liacson-ops/3d-pato-criollo/salida/resumen.md

# Resumen del modelo v0

- Masa total estimada: **1.36 kg**
- Servos: 8× MG996R, 5× MG90S
- Piezas impresas: 31 (460 g de PLA/TPU, con el relleno indicado)

| Paso | Pieza | Tipo | Masa (g) | Descripción |
| ---: | --- | --- | ---: | --- |
| 1 | `paleta_pie_der` | impresa | 10.7 | Pie de pato (paleta) |
| 1 | `paleta_pie_izq` | impresa | 10.7 | Pie de pato (paleta) |
| 1 | `servo_tobillo_der` | comprada | 55.0 | MG996R tobillo (acostado, en el pie) |
| 1 | `servo_tobillo_izq` | comprada | 55.0 | MG996R tobillo (acostado, en el pie) |
| 1 | `soporte_pie_der` | impresa | 15.2 | Cuna del servo del tobillo, sobre la paleta |
| 1 | `soporte_pie_izq` | impresa | 15.2 | Cuna del servo del tobillo, sobre la paleta |
| 1 | `suela_der` | tpu | 4.2 | Suela de TPU |
| 1 | `suela_izq` | tpu | 4.2 | Suela de TPU |
| 2 | `horn_tobillo_der` | comprada | 2.0 |  |
| 2 | `horn_tobillo_izq` | comprada | 2.0 |  |
| 2 | `servo_rodilla_der` | comprada | 55.0 | MG996R rodilla (acostado, en la canilla) |
| 2 | `servo_rodilla_izq` | comprada | 55.0 | MG996R rodilla (acostado, en la canilla) |
| 2 | `soporte_canilla_der` | impresa | 16.7 | Canilla: cuna del servo de la rodilla; abajo recibe el horn del tobillo |
| 2 | `soporte_canilla_izq` | impresa | 16.7 | Canilla: cuna del servo de la rodilla; abajo recibe el horn del tobillo |
| 3 | `horn_rodilla_der` | comprada | 2.0 |  |
| 3 | `horn_rodilla_izq` | comprada | 2.0 |  |
| 3 | `servo_cadera_pitch_der` | comprada | 55.0 | MG996R cadera pitch (acostado, en el muslo) |
| 3 | `servo_cadera_pitch_izq` | comprada | 55.0 | MG996R cadera pitch (acostado, en el muslo) |
| 3 | `soporte_muslo_der` | impresa | 16.7 | Muslo: cuna del servo pitch de cadera; abajo recibe el horn de la rodilla |
| 3 | `soporte_muslo_izq` | impresa | 16.7 | Muslo: cuna del servo pitch de cadera; abajo recibe el horn de la rodilla |
| 4 | `horn_cadera_pitch_der` | comprada | 2.0 |  |
| 4 | `horn_cadera_pitch_izq` | comprada | 2.0 |  |
| 4 | `soporte_u_der` | impresa | 11.3 | Soporte U de cadera: cuelga del servo roll, recibe el horn y el pin del muslo |
| 4 | `soporte_u_izq` | impresa | 11.3 | Soporte U de cadera: cuelga del servo roll, recibe el horn y el pin del muslo |
| 5 | `horn_cadera_roll_der` | comprada | 2.0 |  |
| 5 | `horn_cadera_roll_izq` | comprada | 2.0 |  |
| 5 | `placa_yaw_der` | impresa | 6.7 | Placa yaw: sostiene el servo roll por las orejas y sube al rulemán |
| 5 | `placa_yaw_izq` | impresa | 6.7 | Placa yaw: sostiene el servo roll por las orejas y sube al rulemán |
| 5 | `servo_cadera_roll_der` | comprada | 55.0 | MG996R cadera roll |
| 5 | `servo_cadera_roll_izq` | comprada | 55.0 | MG996R cadera roll |
| 6 | `horn_cadera_yaw_der` | comprada | 1.0 |  |
| 6 | `horn_cadera_yaw_izq` | comprada | 1.0 |  |
| 6 | `piso_tronco` | impresa | 50.9 | Piso del tronco con alojamientos 608 |
| 6 | `ruleman_cadera_der` | comprada | 12.0 | Rulemán 608ZZ |
| 6 | `ruleman_cadera_izq` | comprada | 12.0 | Rulemán 608ZZ |
| 6 | `servo_cadera_yaw_der` | comprada | 55.0 | MG996R cadera yaw (parado, las orejas van contra el estante A) |
| 6 | `servo_cadera_yaw_izq` | comprada | 55.0 | MG996R cadera yaw (parado, las orejas van contra el estante A) |
| 7 | `estante_a` | impresa | 15.4 | Estante A |
| 7 | `lipo_2s_1500` | comprada | 85.0 | LiPo 2S 1500 mAh |
| 7 | `placa_mcp3008` | comprada | 10.0 | 2× MCP3008 + divisores |
| 7 | `tapa_bateria` | impresa | 3.2 | Tapa y traba de la batería |
| 7 | `xl4016_der` | comprada | 35.0 | Regulador XL4016 6,0 V (pata derecha) |
| 7 | `xl4016_izq` | comprada | 35.0 | Regulador XL4016 6,0 V (pata izquierda) |
| 8 | `estante_b` | impresa | 17.0 | Estante B |
| 8 | `imu_gy521` | comprada | 2.0 | IMU MPU-6050 (GY-521) |
| 8 | `mini560_5v` | comprada | 2.0 | Mini560 5 V (Pi) |
| 8 | `pca9685` | comprada | 9.0 | PCA9685 (16 PWM) |
| 8 | `pi_zero_2w` | comprada | 13.0 | Raspberry Pi Zero 2 W |
| 9 | `horn_cuello_pitch` | comprada | 1.0 |  |
| 9 | `horn_cuello_yaw` | comprada | 1.0 |  |
| 9 | `servo_cuello_pitch` | comprada | 13.4 | MG90S cuello pitch |
| 9 | `servo_cuello_yaw` | comprada | 13.4 | MG90S cuello yaw |
| 9 | `soporte_cuello` | impresa | 4.1 | Soporte del cuello (yaw → pitch) |
| 10 | `base_cabeza` | impresa | 20.9 | Base de la cabeza: une el cuello, el servo de la boca y la cúpula |
| 10 | `camara` | comprada | 3.0 | Cámara de la Pi (en la frente) |
| 10 | `cupula` | impresa | 65.6 | Cúpula de la cabeza |
| 10 | `horn_boca` | comprada | 0.5 |  |
| 10 | `lente` | comprada | 1.0 |  |
| 10 | `mandibula` | impresa | 26.2 | Mandíbula: piso de la cabeza, la mueve el servo de la boca |
| 10 | `ojo_aro_der` | impresa | 0.9 | Aro del ojo |
| 10 | `ojo_aro_izq` | impresa | 0.9 | Aro del ojo |
| 10 | `ojo_disco_der` | impresa | 0.4 | Disco del ojo |
| 10 | `ojo_disco_izq` | impresa | 0.4 | Disco del ojo |
| 10 | `pico_inferior` | impresa | 8.3 | Pico inferior (amarillo, va pegado a la mandíbula) |
| 10 | `pico_superior` | impresa | 7.3 | Pico superior |
| 10 | `servo_boca` | comprada | 13.4 | MG90S boca |
| 10 | `soporte_camara` | impresa | 2.2 | Soporte de la cámara |
| 11 | `cuerpo_inferior` | impresa | 26.3 | Carcasa del cuerpo, mitad inferior |
| 11 | `cuerpo_superior` | impresa | 47.3 | Carcasa del cuerpo, mitad superior |

Más 70 g de cables, conectores y tornillos repartidos.
