liacson-ops/3d-pato-criollo/docs/img/pato_costado.png

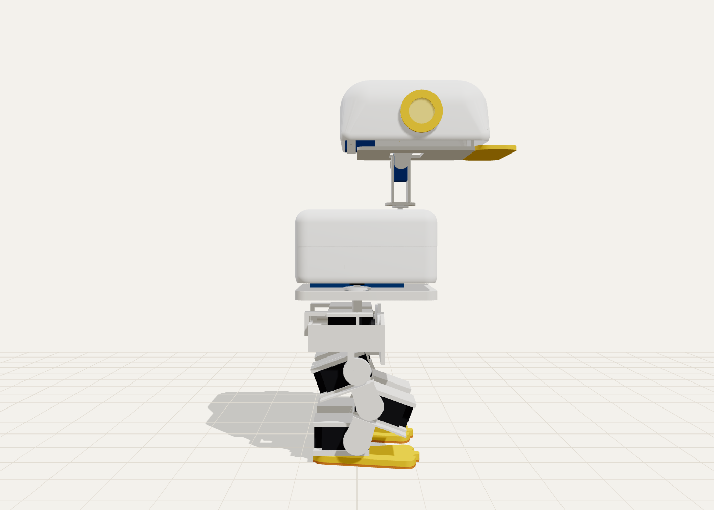
docs/img/pato_costado.png
