liacson-ops/3d-pato-criollo/docs/img/pato_rayos_x_atras.png

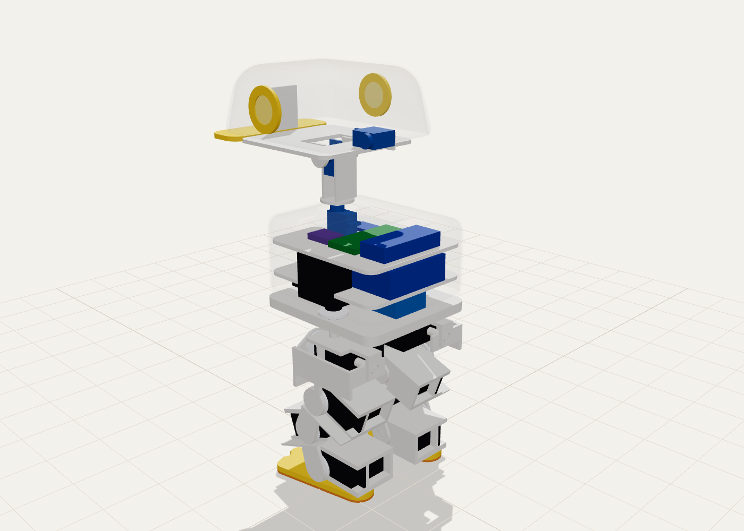
docs/img/pato_rayos_x_atras.png
