liacson-ops/3d-pato-criollo/salida/mjcf/mallas/horn_rodilla_izq.stl

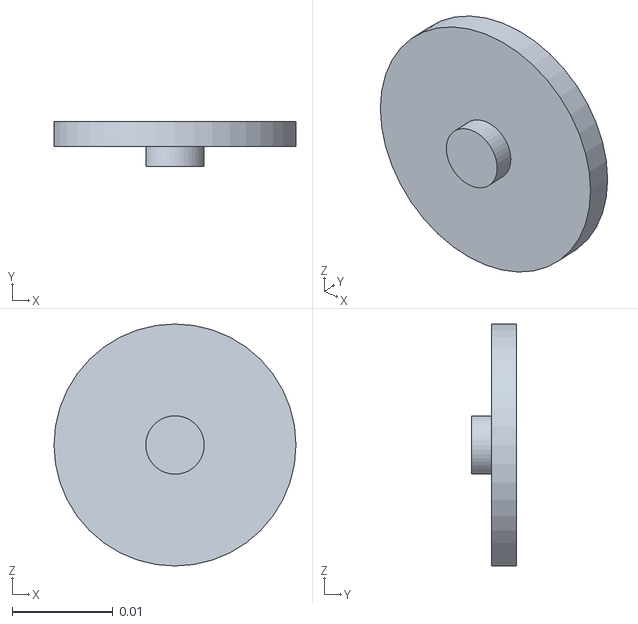
[picture p20: CAD file, 2026-10-25]
salida/mjcf/mallas/horn_rodilla_izq.stl
0.024 x 0.0045 x 0.024
