liacson-ops/3d-pato-criollo/salida/piezas_impresas/mandibula.stl

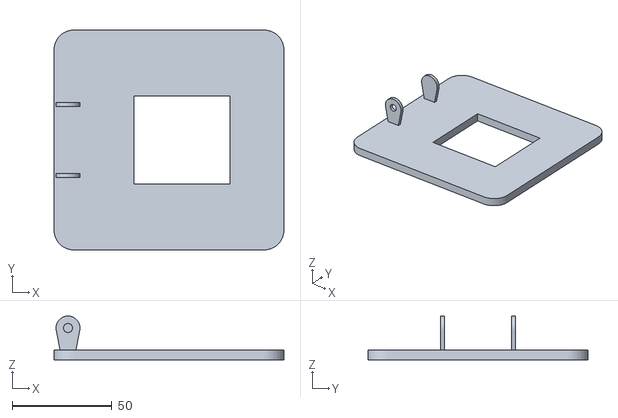
[picture p21: CAD file, 2026-10-25]
salida/piezas_impresas/mandibula.stl
115.0 x 110.0 x 22.0
