liacson-ops/3d-pato-criollo/salida/mjcf/mallas/soporte_pie_der.stl

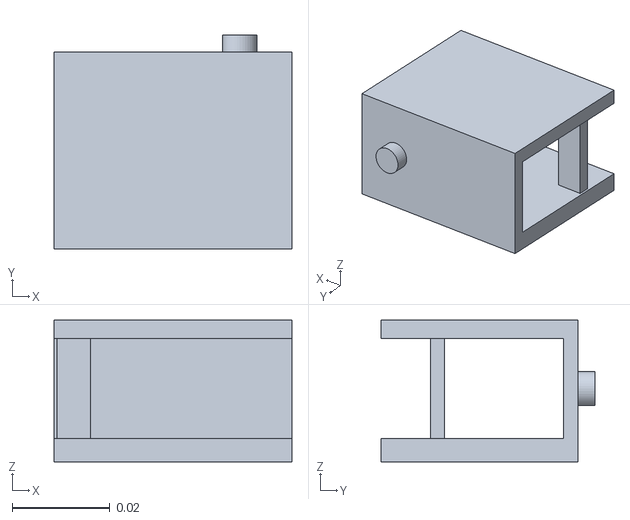
[picture p22: CAD file, 2026-10-25]
salida/mjcf/mallas/soporte_pie_der.stl
0.0487 x 0.0438 x 0.029
