liacson-ops/3d-pato-criollo/salida/piezas_impresas/ojo_disco_izq.stl

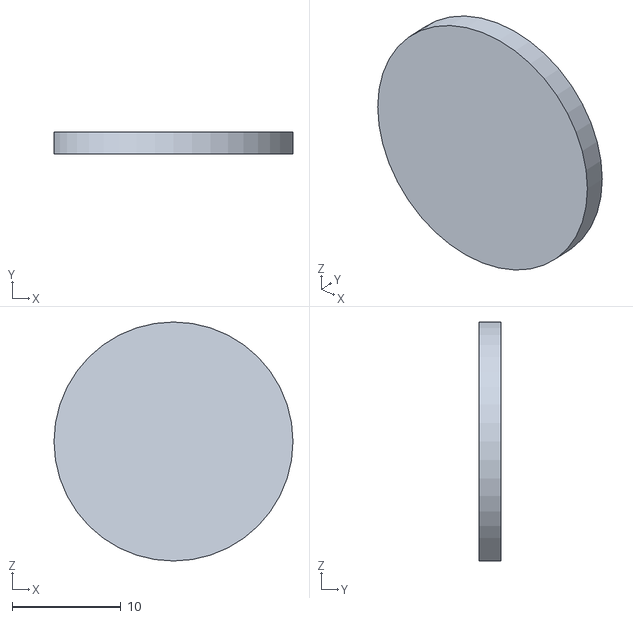
[picture p23: CAD file, 2026-10-25]
salida/piezas_impresas/ojo_disco_izq.stl
22.0 x 2.00 x 22.0
