liacson-ops/3d-pato-criollo/salida/mjcf/mallas/soporte_u_izq.stl

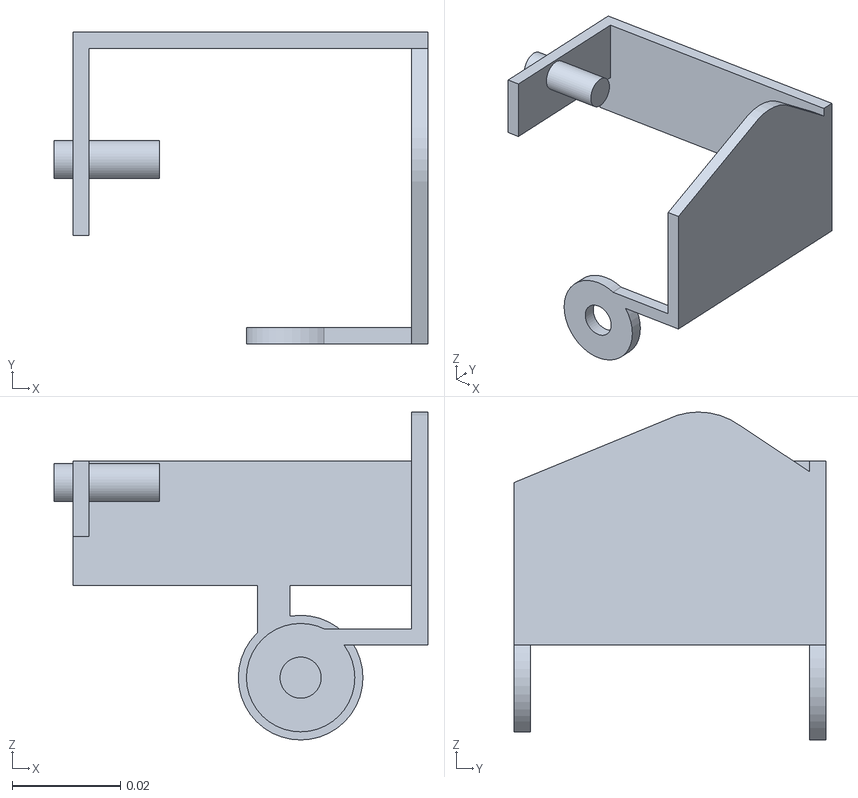
[picture p24: CAD file, 2026-10-25]
salida/mjcf/mallas/soporte_u_izq.stl
0.069 x 0.0575 x 0.0605
