liacson-ops/3d-pato-criollo/salida/piezas_impresas/pico_inferior.stl

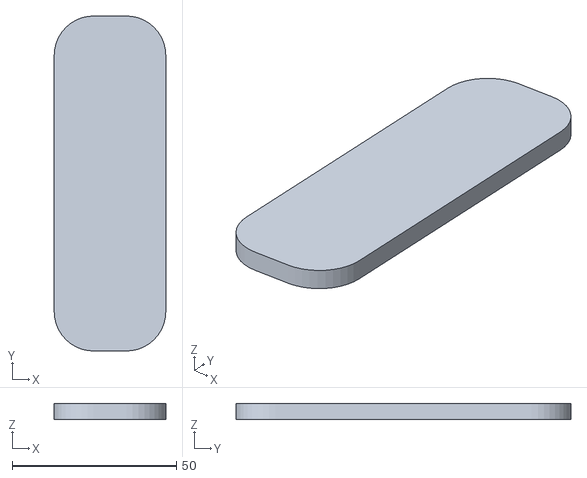
[picture p25: CAD file, 2026-10-25]
salida/piezas_impresas/pico_inferior.stl
34.0 x 102.0 x 5.00
