liacson-ops/3d-pato-criollo/salida/mjcf/mallas/servo_rodilla_izq.stl

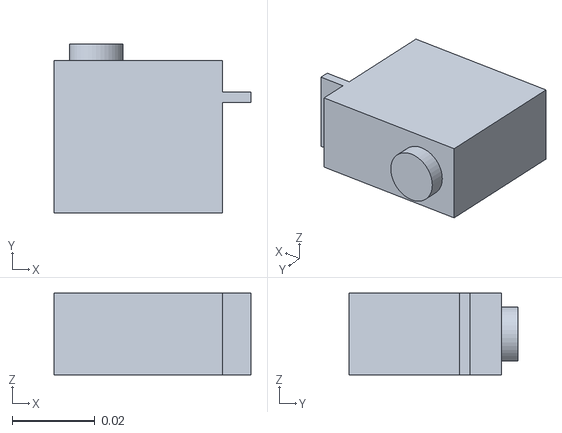
[picture p26: CAD file, 2026-10-25]
salida/mjcf/mallas/servo_rodilla_izq.stl
0.0476 x 0.0408 x 0.0197
