liacson-ops/3d-pato-criollo/salida/piezas_impresas/base_cabeza.stl

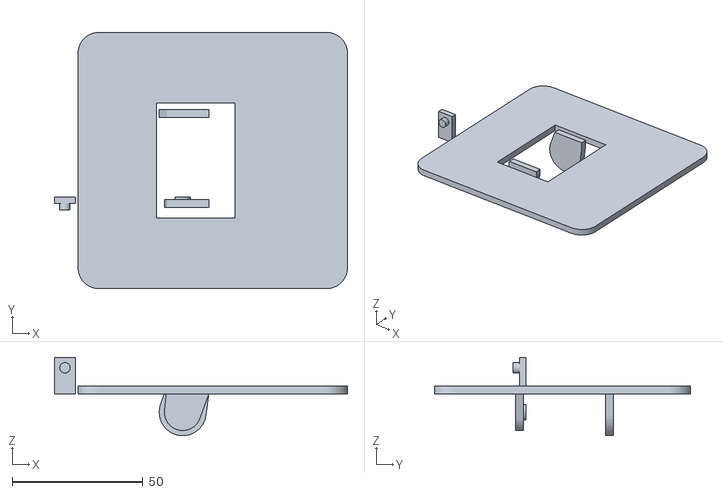
[picture p27: CAD file, 2026-10-25]
salida/piezas_impresas/base_cabeza.stl
112.0 x 98.0 x 30.0
