liacson-ops/3d-pato-criollo/salida/mjcf/mallas/base_cabeza.stl

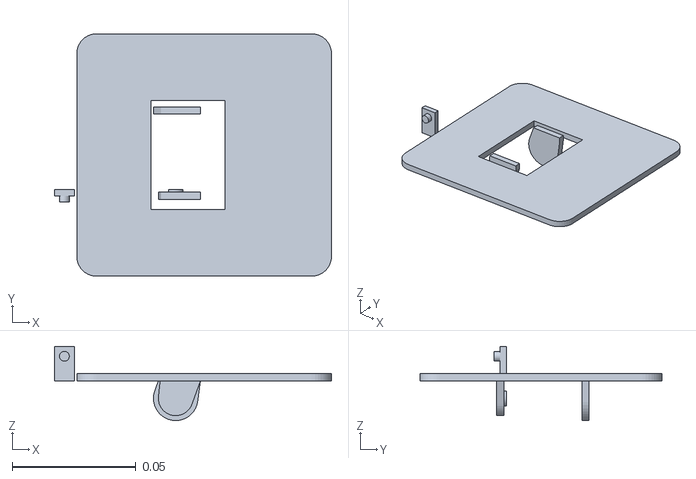
[picture p28: CAD file, 2026-10-25]
salida/mjcf/mallas/base_cabeza.stl
0.112 x 0.098 x 0.03
