liacson-ops/3d-pato-criollo/salida/piezas_impresas/piso_tronco.stl

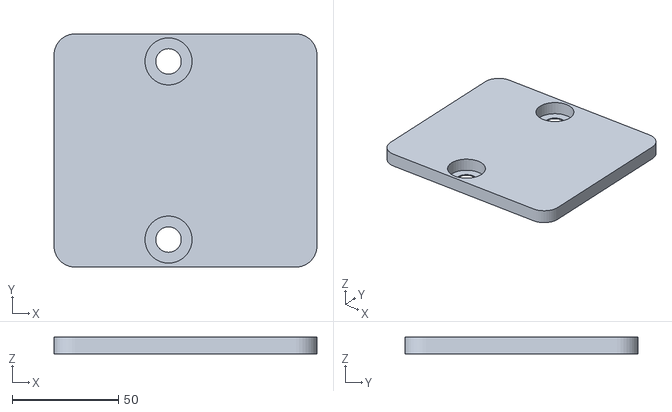
[picture p29: CAD file, 2026-10-25]
salida/piezas_impresas/piso_tronco.stl
124.0 x 110.0 x 8.00
