liacson-ops/3d-pato-criollo/salida/mjcf/mallas/placa_yaw_der.stl

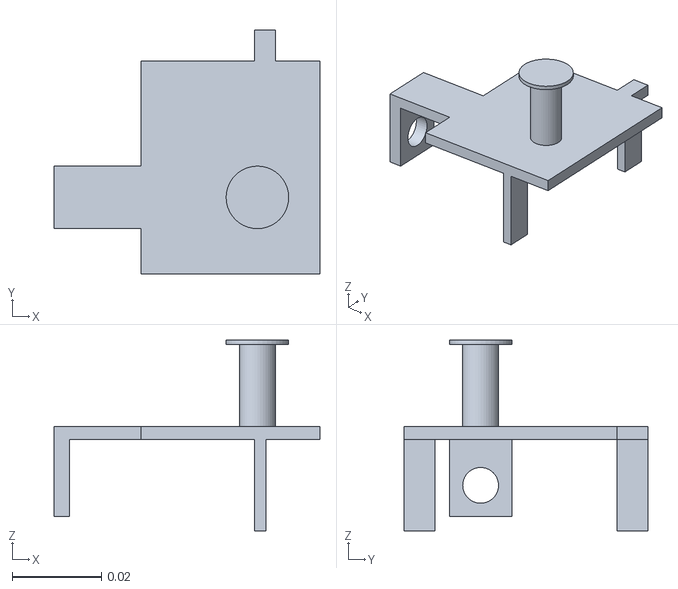
[picture p30: CAD file, 2026-10-25]
salida/mjcf/mallas/placa_yaw_der.stl
0.0595 x 0.0545 x 0.0427
