liacson-ops/3d-pato-criollo/salida/piezas_impresas/placa_yaw_izq.stl

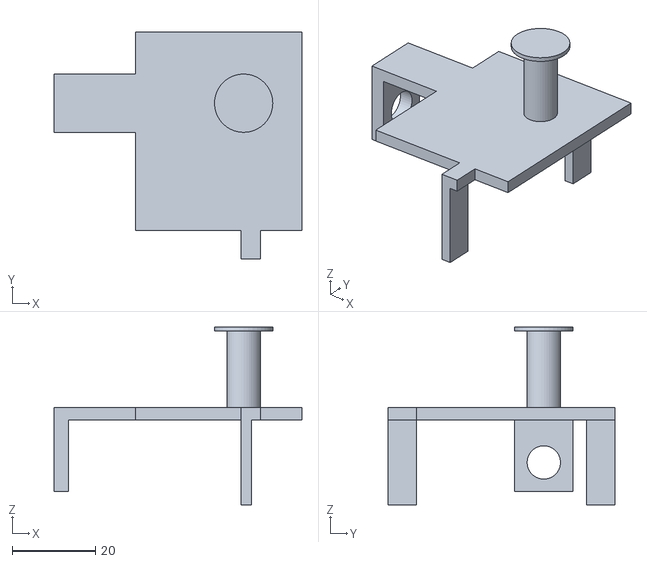
[picture p31: CAD file, 2026-10-25]
salida/piezas_impresas/placa_yaw_izq.stl
59.5 x 54.5 x 42.7
