liacson-ops/3d-pato-criollo/salida/mjcf/mallas/suela_izq.stl

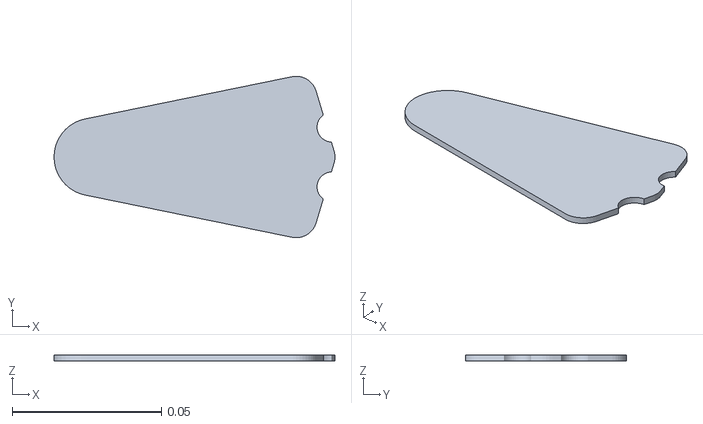
[picture p32: CAD file, 2026-10-25]
salida/mjcf/mallas/suela_izq.stl
0.094 x 0.054 x 0.002
