liacson-ops/3d-pato-criollo/salida/piezas_impresas/cuerpo_superior.stl

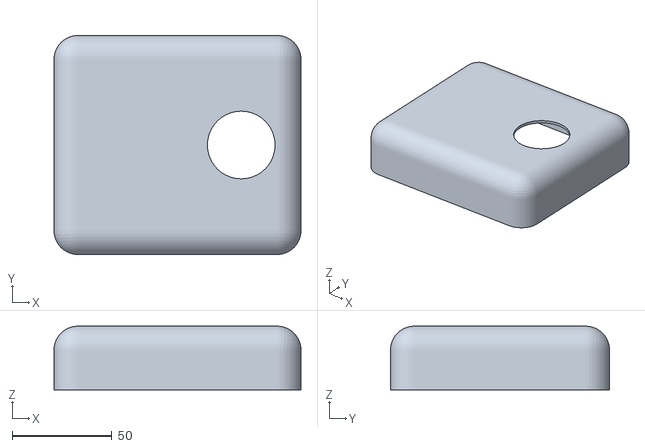
[picture p33: CAD file, 2026-10-25]
salida/piezas_impresas/cuerpo_superior.stl
124.0 x 110.0 x 32.0
