liacson-ops/3d-pato-criollo/salida/mjcf/mallas/estante_b.stl

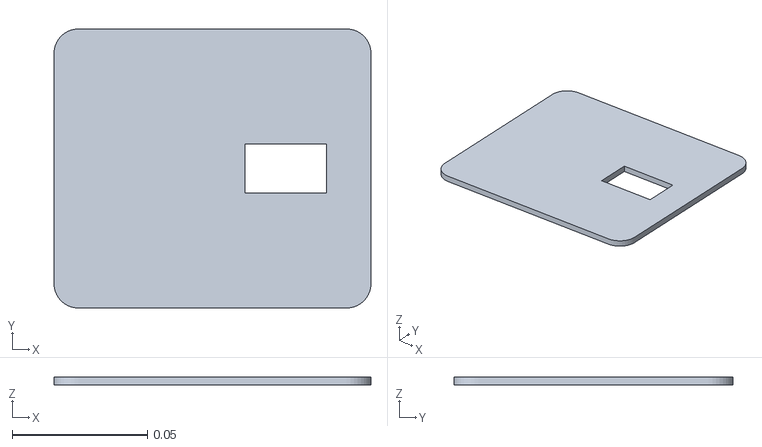
[picture p34: CAD file, 2026-10-25]
salida/mjcf/mallas/estante_b.stl
0.117 x 0.103 x 0.003
