liacson-ops/3d-pato-criollo/salida/piezas_impresas/soporte_pie_izq.stl

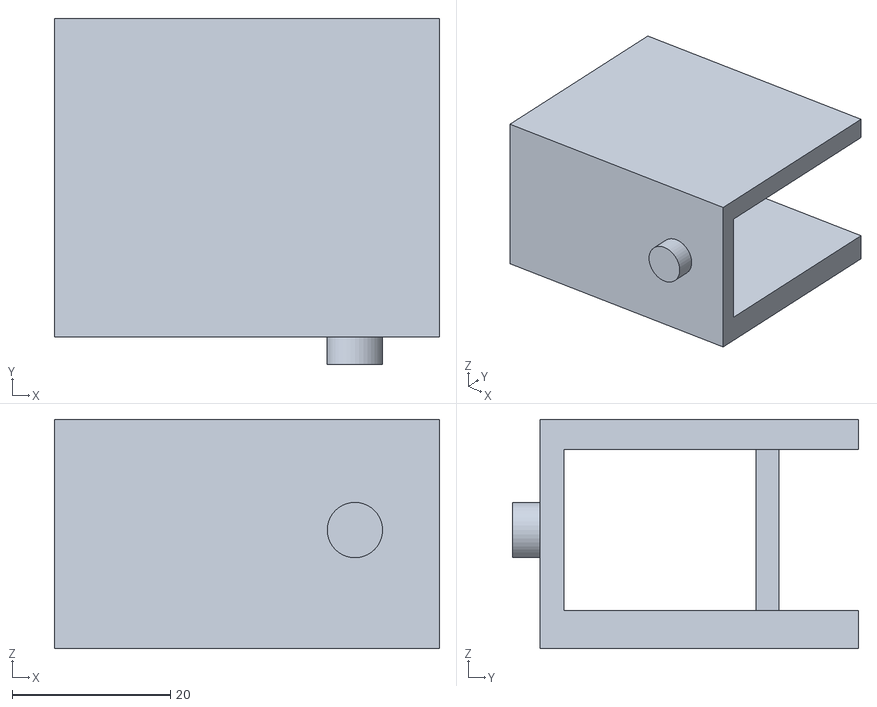
[picture p35: CAD file, 2026-10-25]
salida/piezas_impresas/soporte_pie_izq.stl
48.7 x 43.8 x 29.0
