liacson-ops/3d-pato-criollo/salida/mjcf/mallas/soporte_canilla_izq.stl

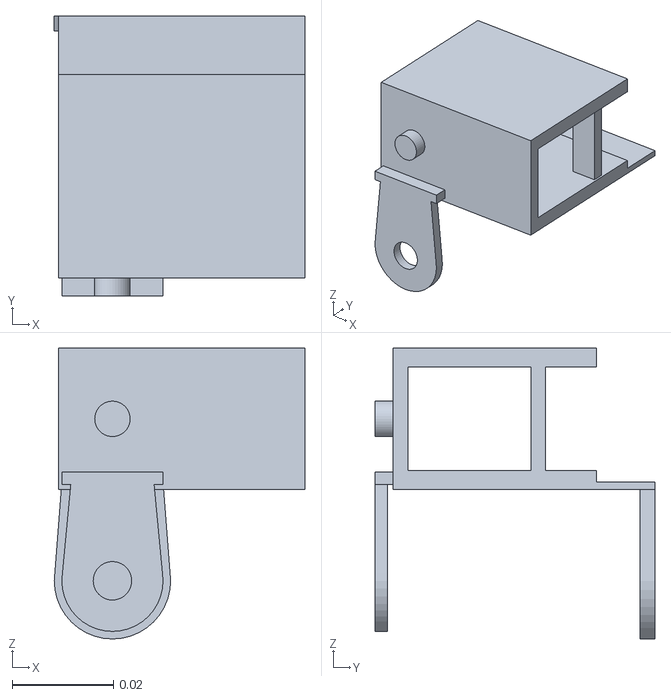
[picture p36: CAD file, 2026-10-25]
salida/mjcf/mallas/soporte_canilla_izq.stl
0.0495 x 0.0553 x 0.0575
