liacson-ops/3d-pato-criollo/salida/piezas_impresas/pico_superior.stl

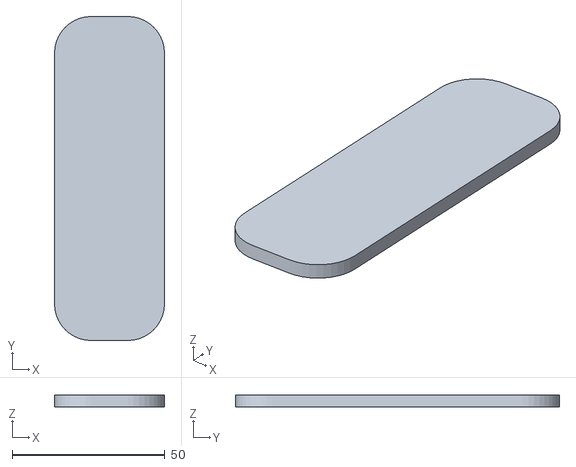
[picture p37: CAD file, 2026-10-25]
salida/piezas_impresas/pico_superior.stl
36.0 x 106.0 x 4.00
