liacson-ops/3d-pato-criollo/salida/piezas_impresas/soporte_canilla_der.stl

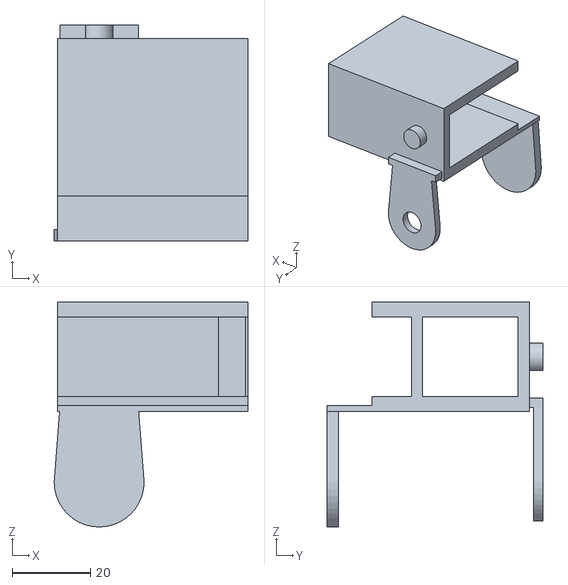
[picture p38: CAD file, 2026-10-25]
salida/piezas_impresas/soporte_canilla_der.stl
49.5 x 55.3 x 57.5
