liacson-ops/3d-pato-criollo/salida/mjcf/mallas/soporte_muslo_izq.stl

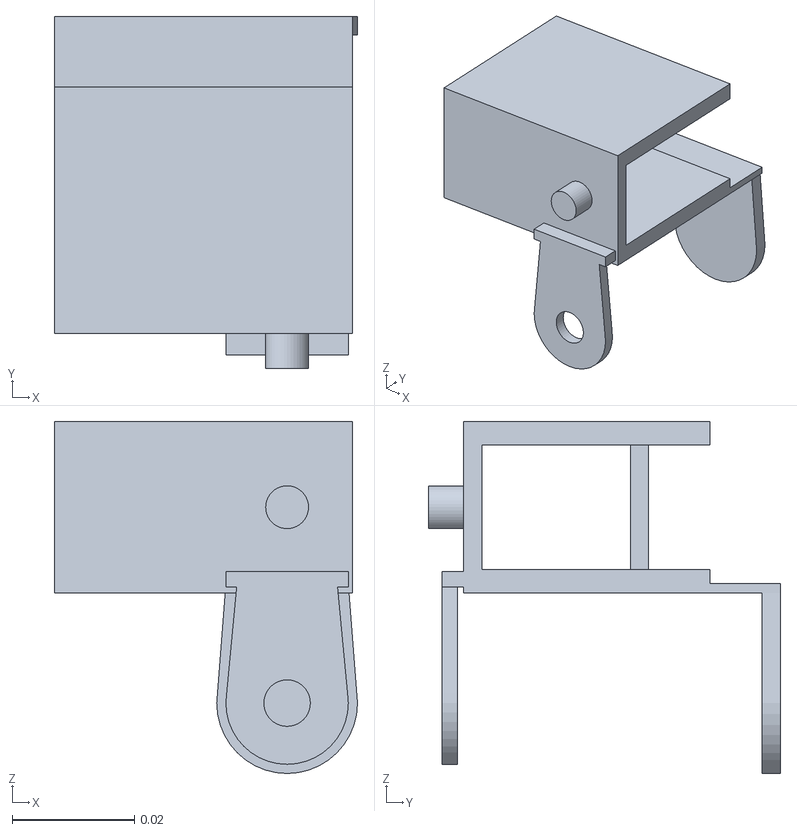
[picture p39: CAD file, 2026-10-25]
salida/mjcf/mallas/soporte_muslo_izq.stl
0.0495 x 0.0575 x 0.0575
