liacson-ops/3d-pato-criollo/salida/piezas_impresas/soporte_u_izq.stl

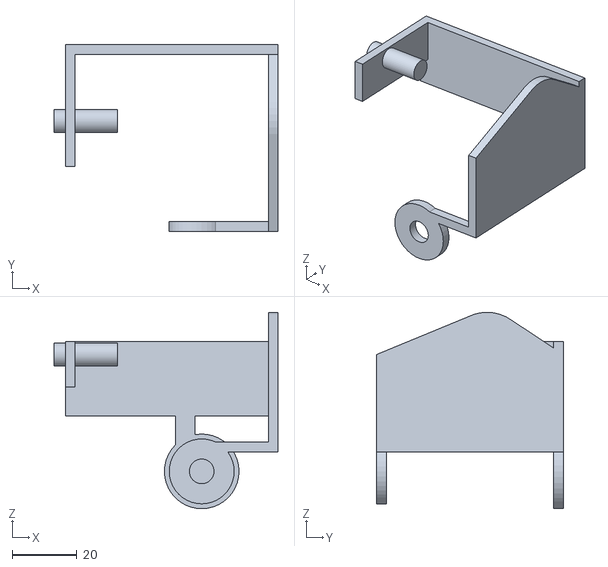
[picture p40: CAD file, 2026-10-25]
salida/piezas_impresas/soporte_u_izq.stl
69.0 x 57.5 x 60.5
