liacson-ops/3d-pato-criollo/salida/piezas_impresas/estante_b.stl

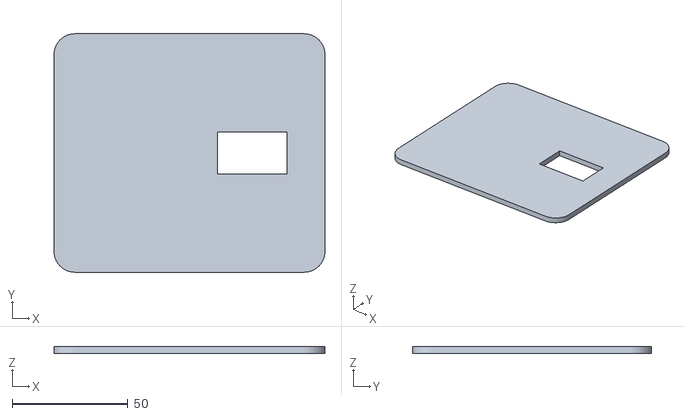
[picture p41: CAD file, 2026-10-25]
salida/piezas_impresas/estante_b.stl
117.0 x 103.0 x 3.00
