liacson-ops/3d-pato-criollo/salida/mjcf/mallas/paleta_pie_der.stl

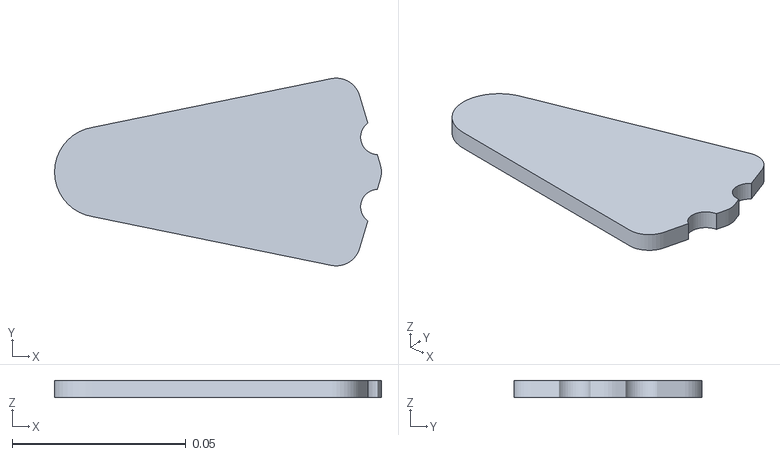
[picture p42: CAD file, 2026-10-25]
salida/mjcf/mallas/paleta_pie_der.stl
0.094 x 0.054 x 0.005
