liacson-ops/3d-pato-criollo/salida/piezas_impresas/soporte_muslo_der.stl

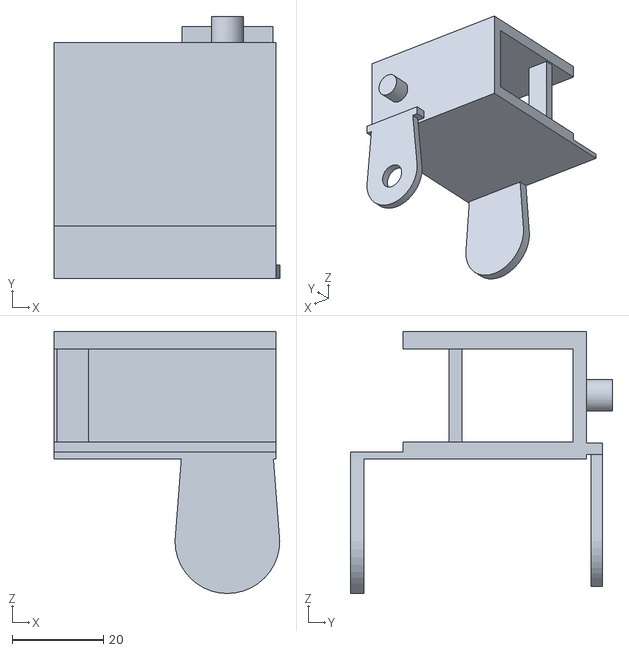
[picture p43: CAD file, 2026-10-25]
salida/piezas_impresas/soporte_muslo_der.stl
49.5 x 57.5 x 57.5
