liacson-ops/3d-pato-criollo/salida/piezas_impresas/suela_der.stl

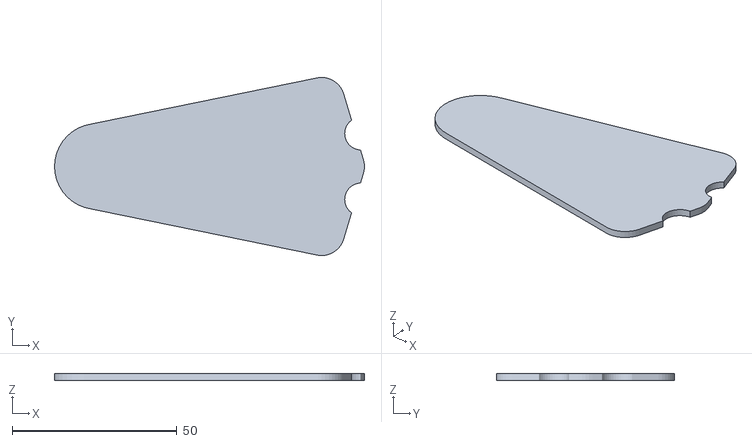
[picture p44: CAD file, 2026-10-25]
salida/piezas_impresas/suela_der.stl
94.0 x 54.0 x 2.00
