liacson-ops/3d-pato-criollo/salida/piezas_impresas/soporte_cuello.stl

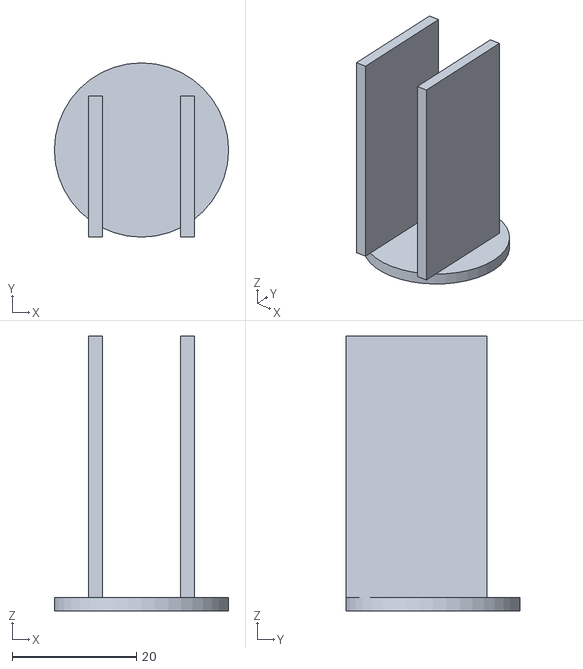
[picture p45: CAD file, 2026-10-25]
salida/piezas_impresas/soporte_cuello.stl
28.0 x 28.0 x 44.2
