liacson-ops/3d-pato-criollo/salida/piezas_impresas/paleta_pie_izq.stl

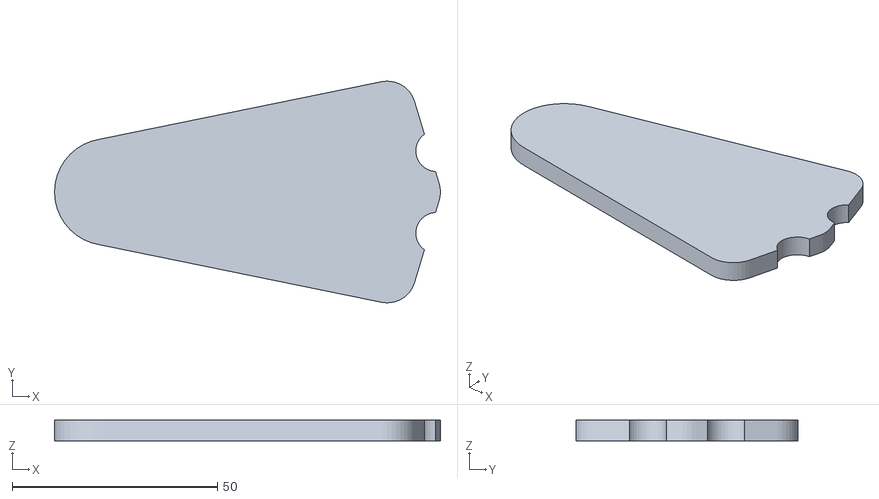
[picture p46: CAD file, 2026-10-25]
salida/piezas_impresas/paleta_pie_izq.stl
94.0 x 54.0 x 5.00
