liacson-ops/3d-pato-criollo/salida/mjcf/mallas/servo_cadera_roll_izq.stl

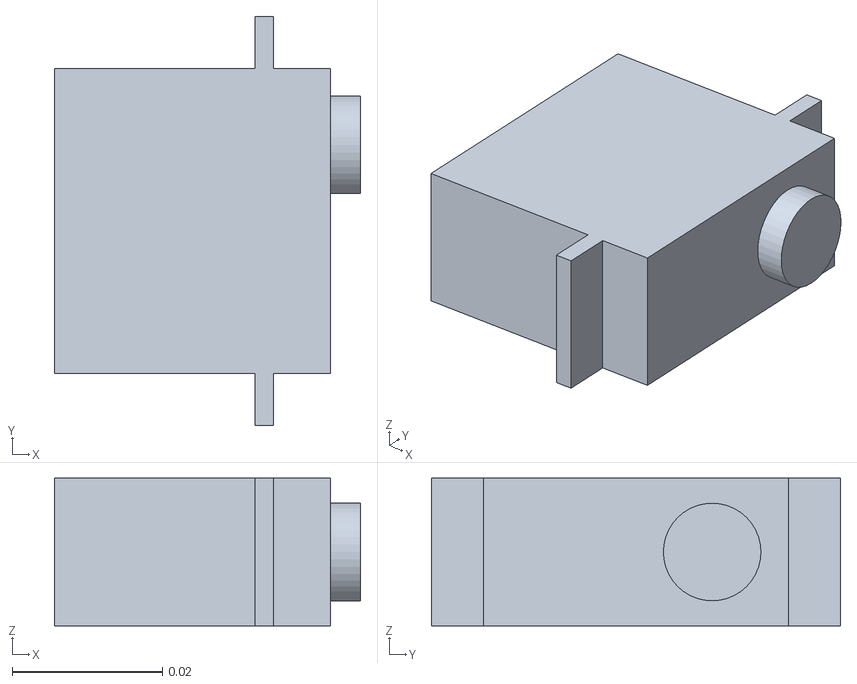
[picture p47: CAD file, 2026-10-25]
salida/mjcf/mallas/servo_cadera_roll_izq.stl
0.0408 x 0.0545 x 0.0197
