liacson-ops/3d-pato-criollo/salida/piezas_impresas/ojo_aro_izq.stl

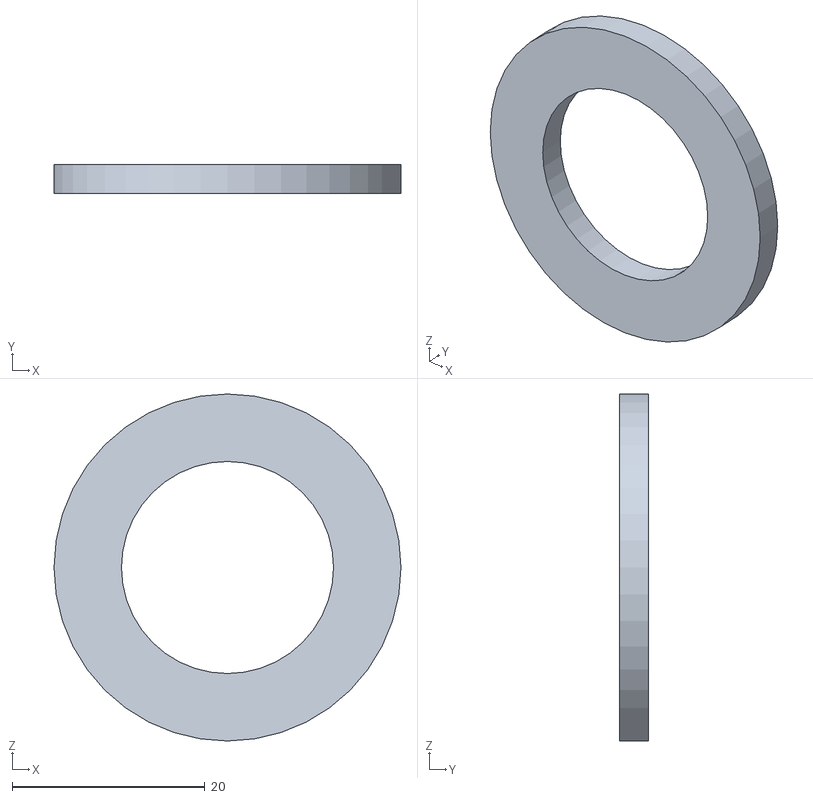
[picture p48: CAD file, 2026-10-25]
salida/piezas_impresas/ojo_aro_izq.stl
36.0 x 3.00 x 36.0
