liacson-ops/3d-pato-criollo/salida/piezas_impresas/tapa_bateria.stl

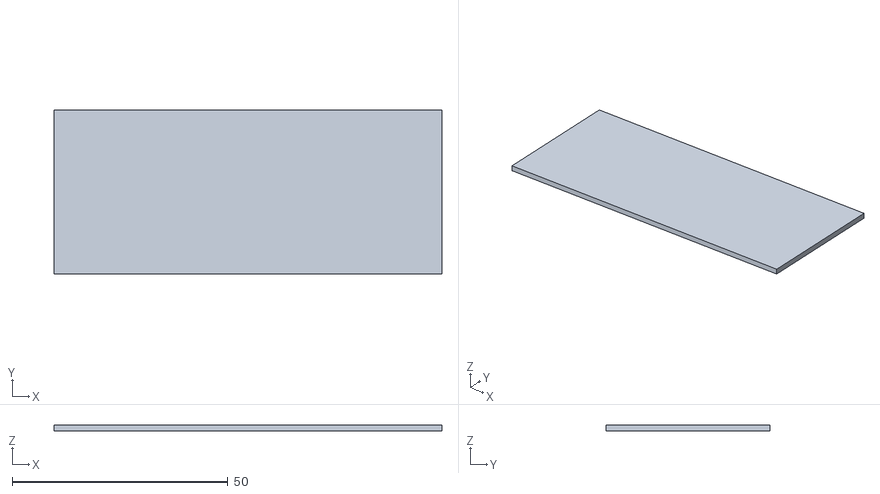
[picture p49: CAD file, 2026-10-25]
salida/piezas_impresas/tapa_bateria.stl
90.0 x 38.0 x 1.50
