liacson-ops/3d-pato-criollo/salida/piezas_impresas/cupula.stl

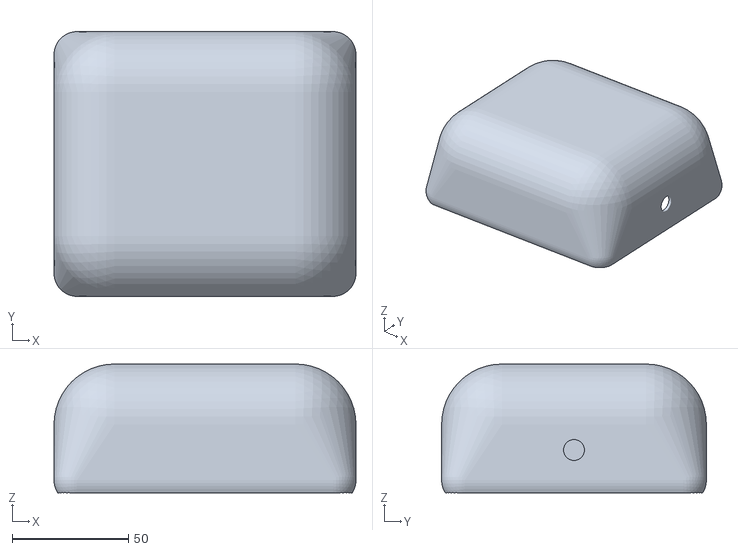
[picture p51: CAD file, 2026-10-25]
salida/piezas_impresas/cupula.stl
130.0 x 114.0 x 55.5
