liacson-ops/3d-pato-criollo/salida/mjcf/mallas/mandibula.stl

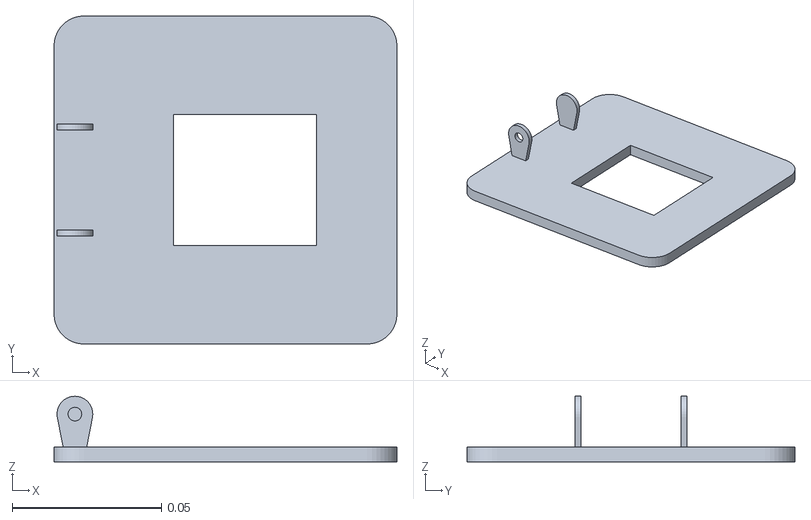
[picture p52: CAD file, 2026-10-25]
salida/mjcf/mallas/mandibula.stl
0.115 x 0.11 x 0.022
