liacson-ops/3d-pato-criollo/salida/mjcf/mallas/soporte_cuello.stl

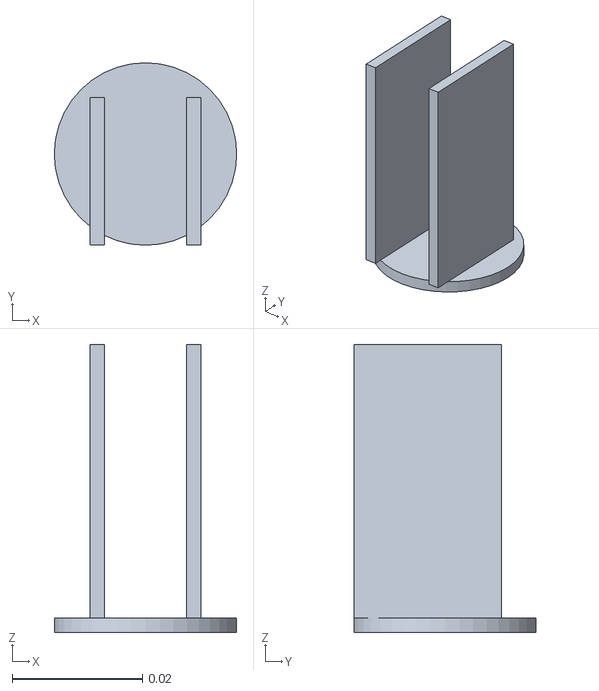
[picture p53: CAD file, 2026-10-25]
salida/mjcf/mallas/soporte_cuello.stl
0.028 x 0.028 x 0.0442
