liacson-ops/3d-pato-criollo/salida/piezas_impresas/cuerpo_inferior.stl

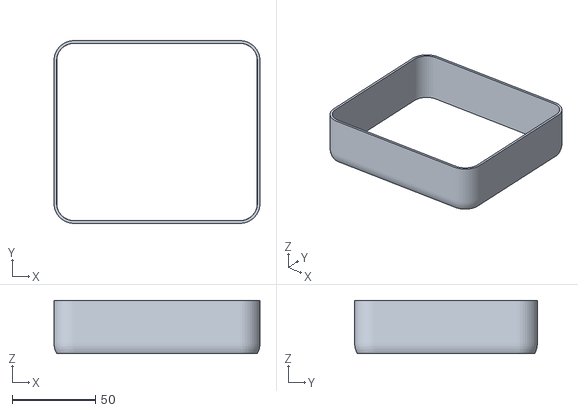
[picture p55: CAD file, 2026-10-25]
salida/piezas_impresas/cuerpo_inferior.stl
124.0 x 110.0 x 32.1
