liacson-ops/3d-pato-criollo/salida/piezas_impresas/soporte_camara.stl

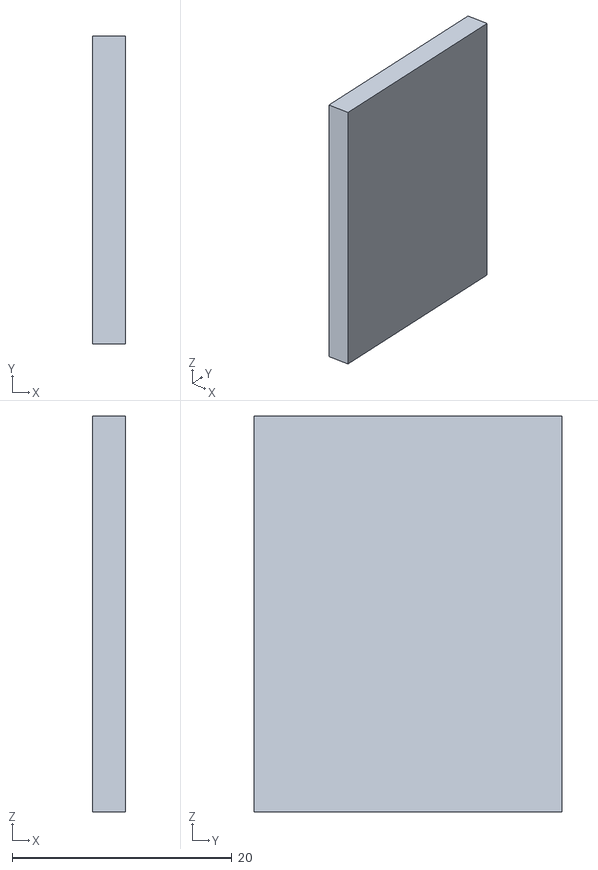
[picture p57: CAD file, 2026-10-25]
salida/piezas_impresas/soporte_camara.stl
3.00 x 28.0 x 36.0
