liacson-ops/3d-pato-criollo/salida/mjcf/mallas/cuerpo_inferior.stl

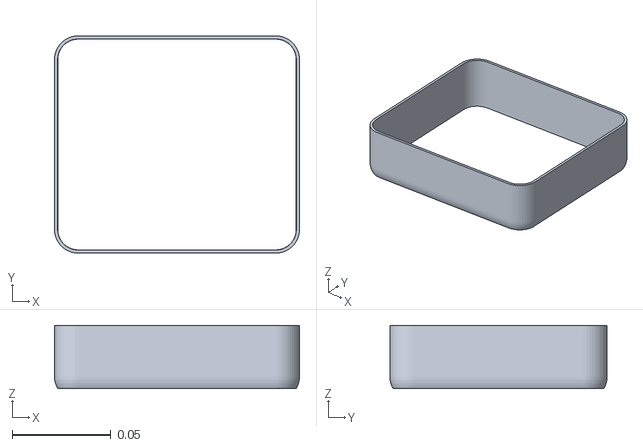
[picture p58: CAD file, 2026-10-25]
salida/mjcf/mallas/cuerpo_inferior.stl
0.124 x 0.11 x 0.0321
