liacson-ops/3d-pato-criollo/salida/piezas_impresas/orejas_tobillo_izq.stl

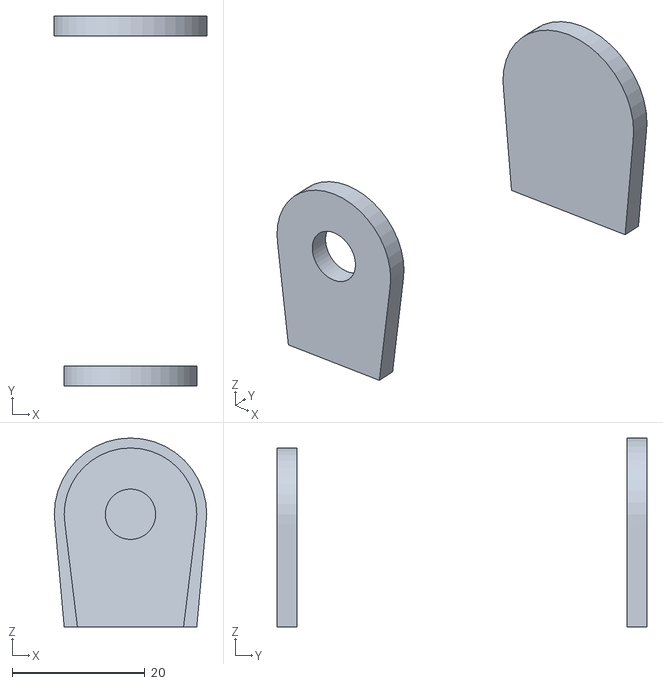
[picture p59: CAD file, 2026-10-25]
salida/piezas_impresas/orejas_tobillo_izq.stl
23.0 x 55.8 x 28.5
