liacson-ops/3d-pato-criollo/salida/mjcf/mallas/servo_cuello_pitch.stl

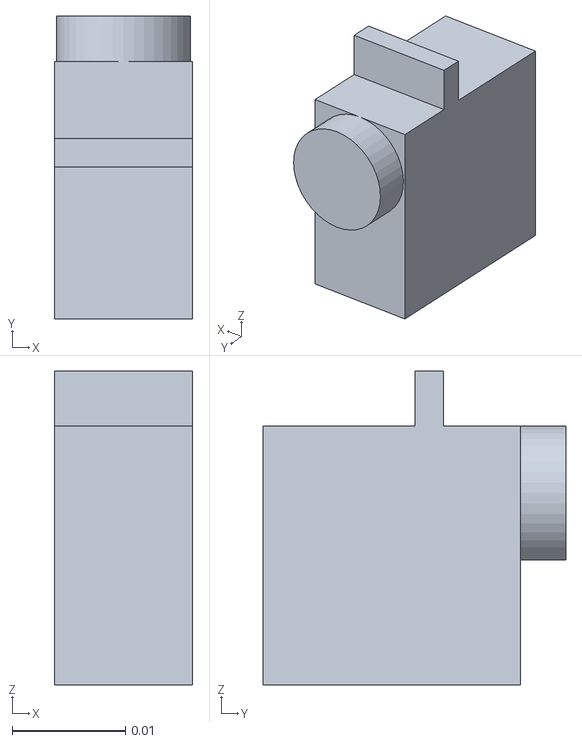
[picture p60: CAD file, 2026-10-25]
salida/mjcf/mallas/servo_cuello_pitch.stl
0.0122 x 0.0267 x 0.0276
