liacson-ops/3d-pato-criollo/salida/piezas_impresas/cabeza_inferior.stl

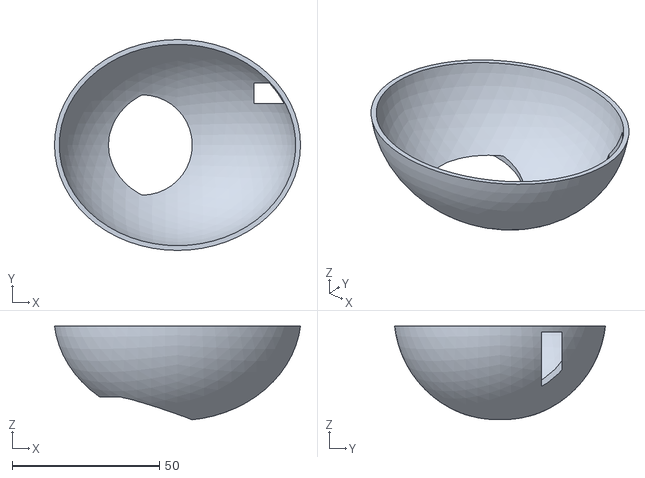
[picture p61: CAD file, 2026-10-25]
salida/piezas_impresas/cabeza_inferior.stl
83.4 x 71.5 x 31.7
