liacson-ops/3d-pato-criollo/salida/piezas_impresas/pico_inf.stl

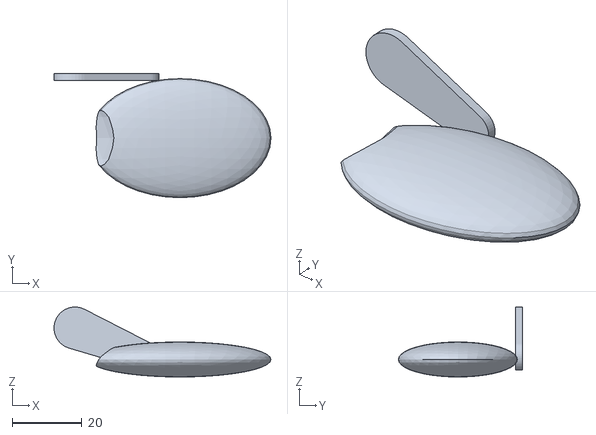
[picture p62: CAD file, 2026-10-25]
salida/piezas_impresas/pico_inf.stl
62.0 x 35.5 x 20.0
