liacson-ops/3d-pato-criollo/salida/piezas_impresas/cabeza_superior.stl

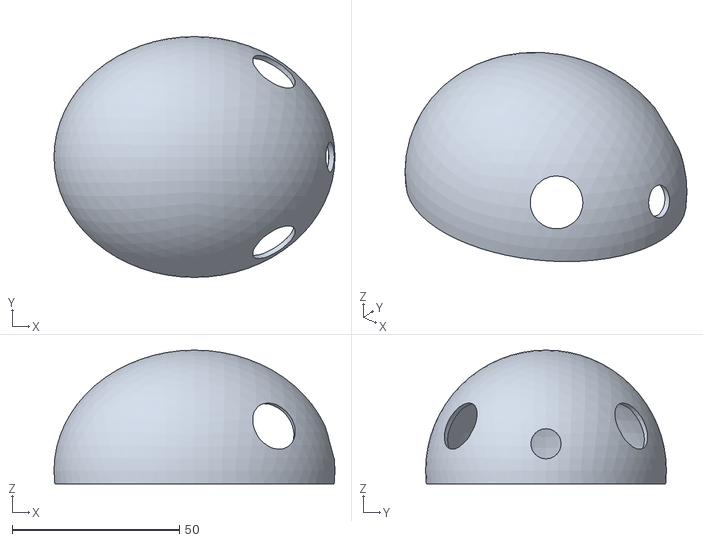
[picture p63: CAD file, 2026-10-25]
salida/piezas_impresas/cabeza_superior.stl
84.0 x 72.0 x 40.0
