liacson-ops/3d-pato-criollo/salida/piezas_impresas/ojos.stl

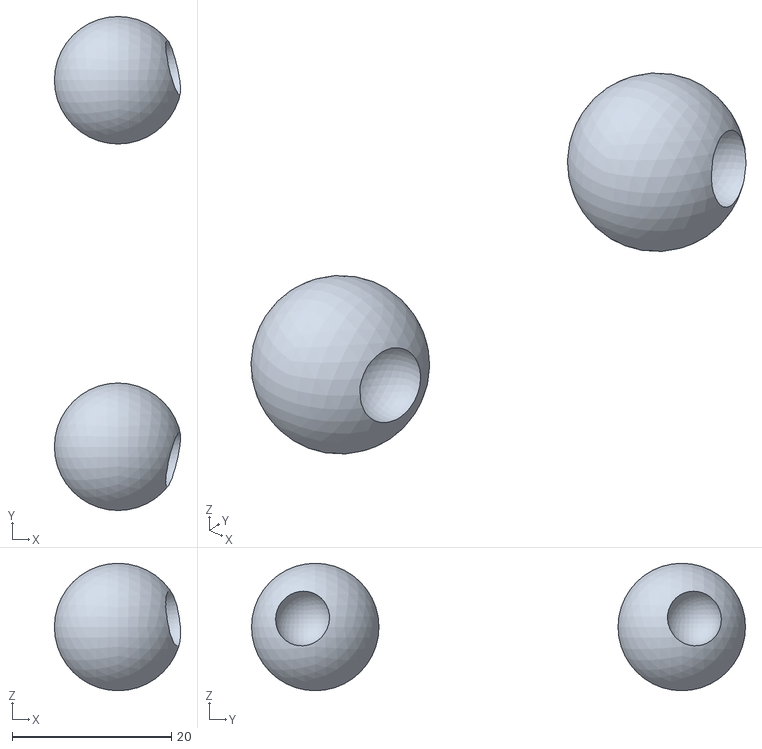
[picture p64: CAD file, 2026-10-25]
salida/piezas_impresas/ojos.stl
15.8 x 62.0 x 16.0
