liacson-ops/3d-pato-criollo/salida/piezas_impresas/pupilas.stl

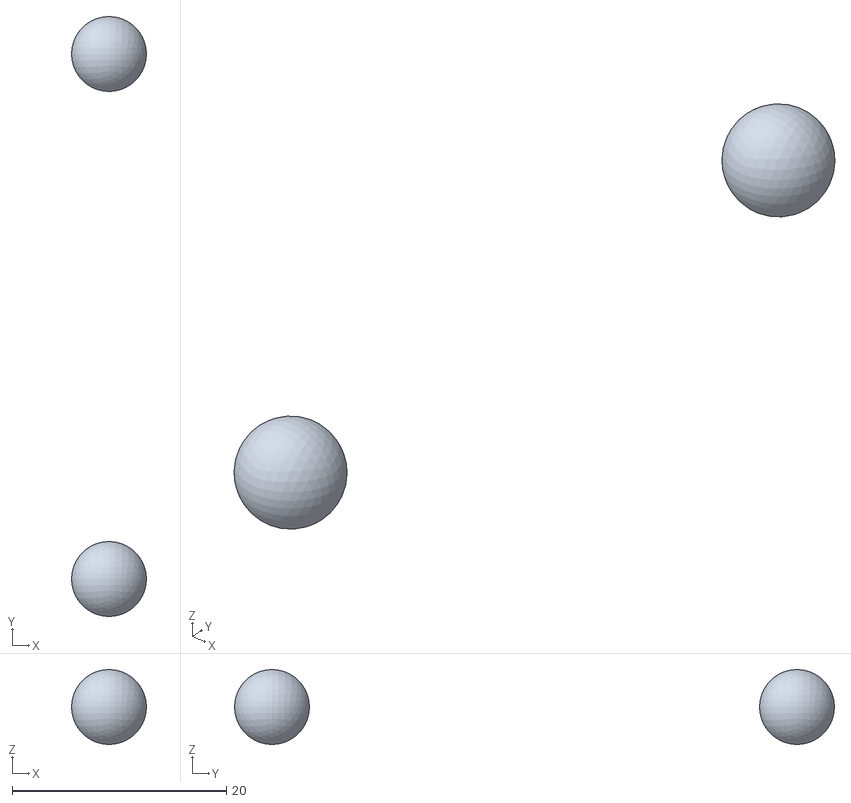
[picture p65: CAD file, 2026-10-25]
salida/piezas_impresas/pupilas.stl
7.00 x 56.0 x 7.00
