liacson-ops/3d-pato-criollo/salida/mjcf/mallas/pico_superior.stl

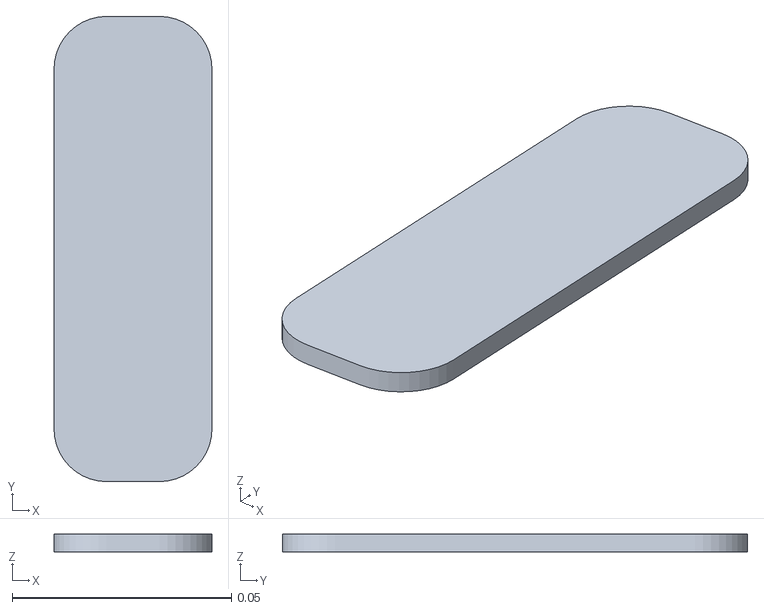
[picture p66: CAD file, 2026-10-25]
salida/mjcf/mallas/pico_superior.stl
0.036 x 0.106 x 0.004
