liacson-ops/3d-pato-criollo/salida/piezas_impresas/soporte_cabeza.stl

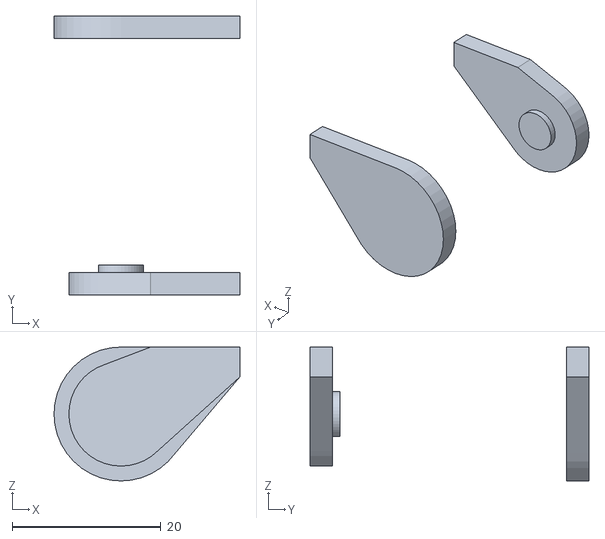
[picture p67: CAD file, 2026-10-25]
salida/piezas_impresas/soporte_cabeza.stl
25.0 x 37.5 x 18.0
