liacson-ops/3d-pato-criollo/salida/mjcf/mallas/xl4016_der.stl

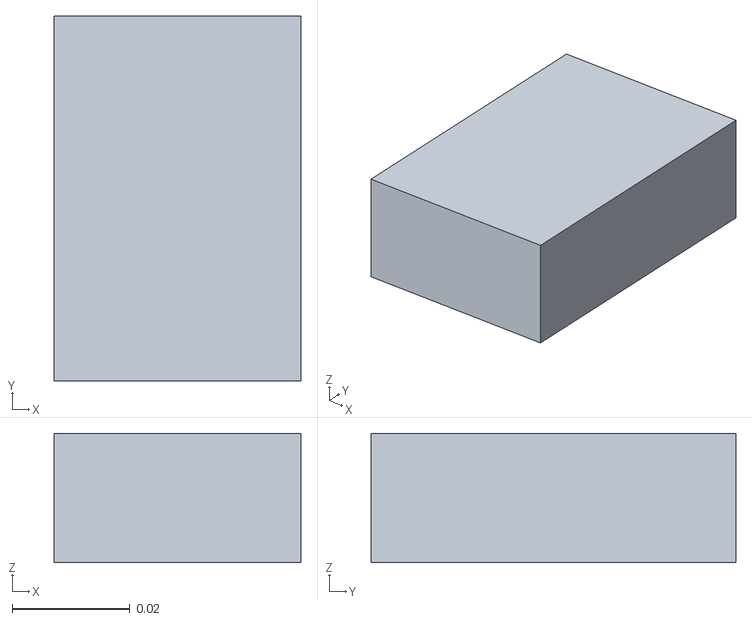
[picture p68: CAD file, 2026-10-25]
salida/mjcf/mallas/xl4016_der.stl
0.042 x 0.062 x 0.022
