liacson-ops/3d-pato-criollo/salida/mjcf/mallas/imu_gy521.stl

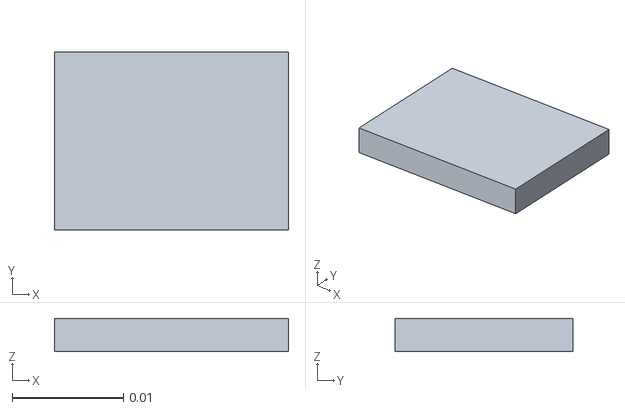
[picture p69: CAD file, 2026-10-25]
salida/mjcf/mallas/imu_gy521.stl
0.021 x 0.016 x 0.003
