liacson-ops/3d-pato-criollo/salida/mjcf/mallas/ojo_disco_der.stl

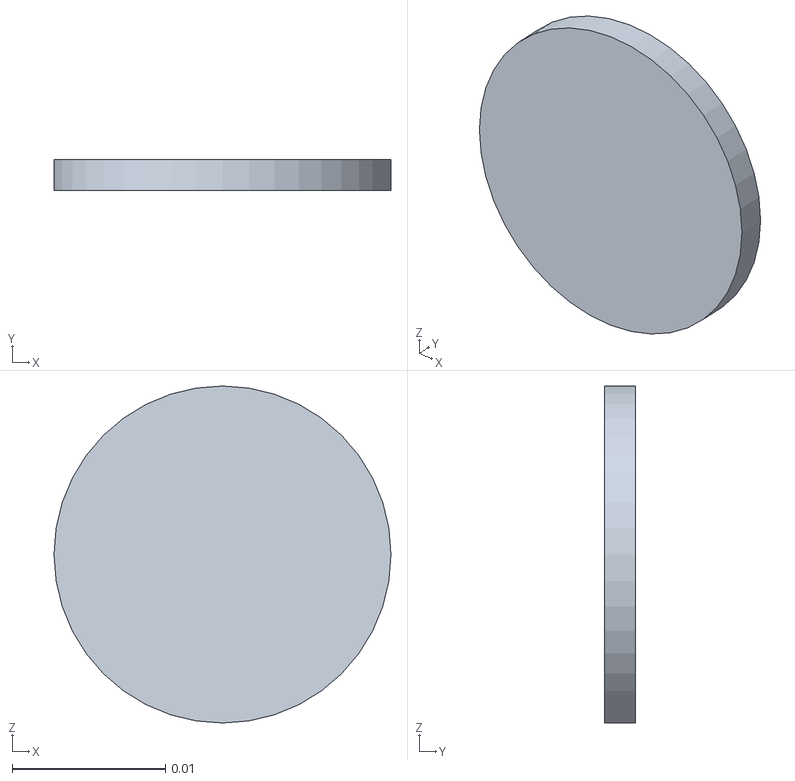
[picture p70: CAD file, 2026-10-25]
salida/mjcf/mallas/ojo_disco_der.stl
0.022 x 0.002 x 0.022
