liacson-ops/3d-pato-criollo/salida/mjcf/mallas/pi_zero_2w.stl

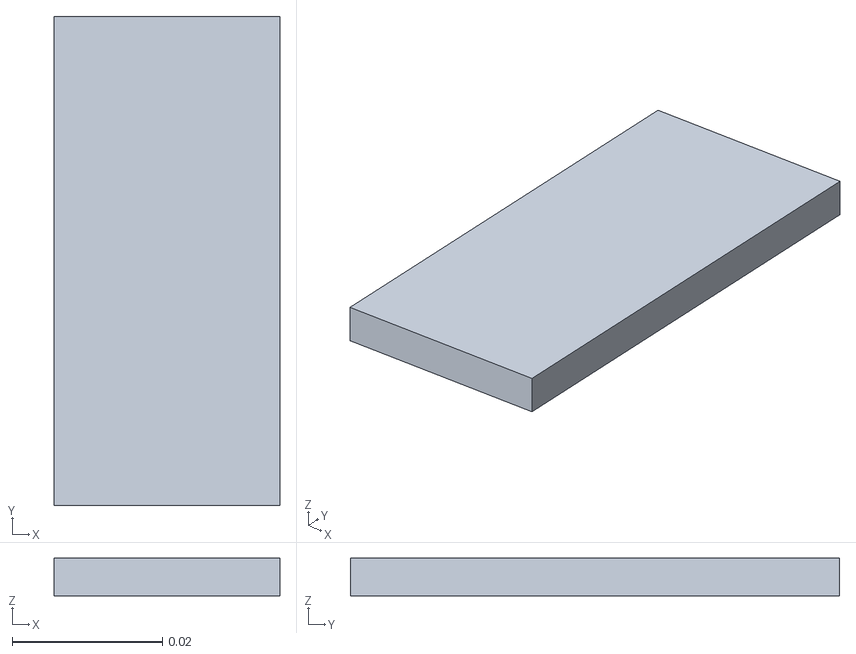
[picture p71: CAD file, 2026-10-25]
salida/mjcf/mallas/pi_zero_2w.stl
0.03 x 0.065 x 0.005
