liacson-ops/3d-pato-criollo/salida/mjcf/mallas/mini560_5v.stl

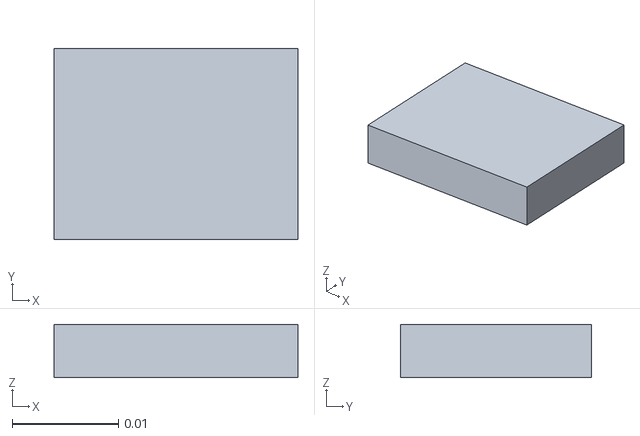
[picture p72: CAD file, 2026-10-25]
salida/mjcf/mallas/mini560_5v.stl
0.023 x 0.018 x 0.005
