liacson-ops/3d-pato-criollo/salida/mjcf/mallas/ojo_aro_der.stl

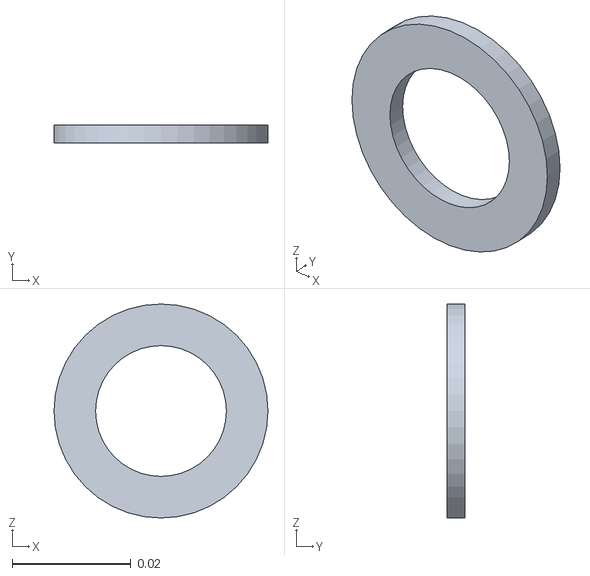
[picture p73: CAD file, 2026-10-25]
salida/mjcf/mallas/ojo_aro_der.stl
0.036 x 0.003 x 0.036
