liacson-ops/3d-pato-criollo/salida/mjcf/mallas/placa_mcp3008.stl

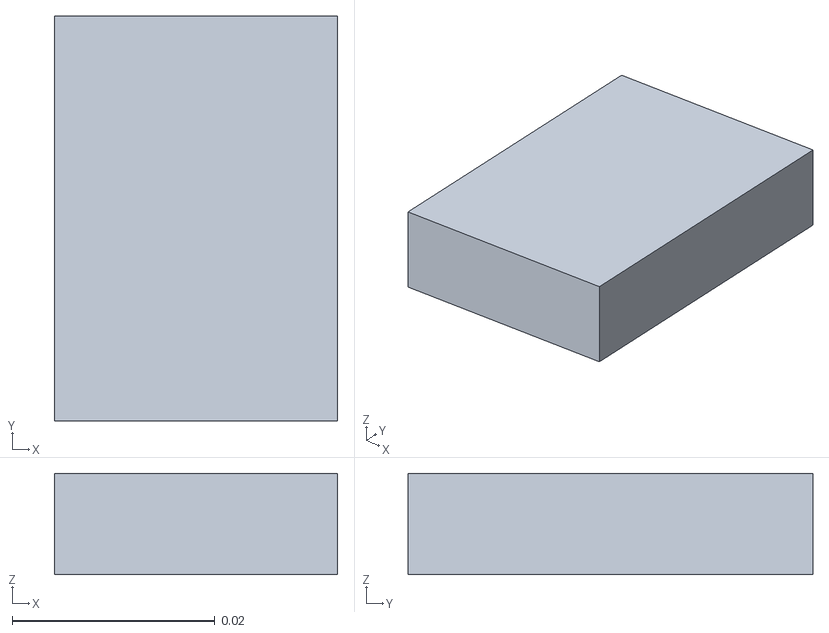
[picture p74: CAD file, 2026-10-25]
salida/mjcf/mallas/placa_mcp3008.stl
0.028 x 0.04 x 0.01
