liacson-ops/3d-pato-criollo/salida/mjcf/mallas/pca9685.stl

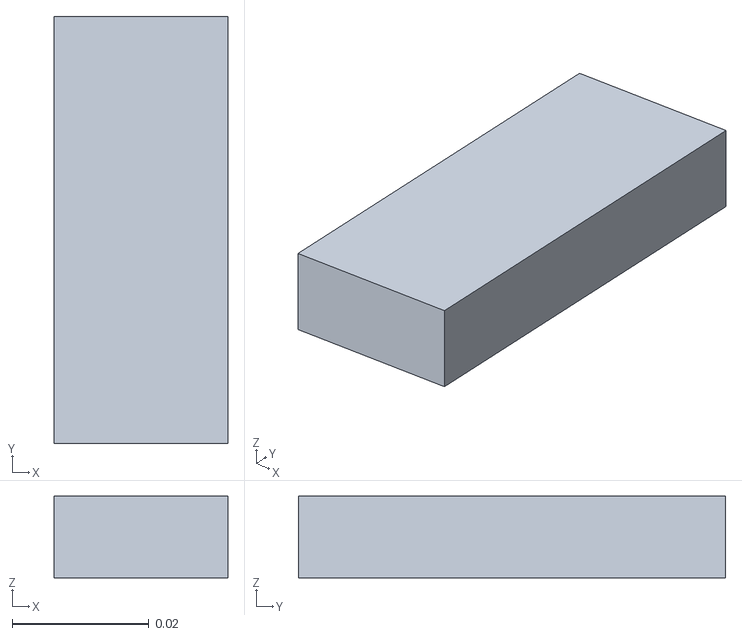
[picture p75: CAD file, 2026-10-25]
salida/mjcf/mallas/pca9685.stl
0.0254 x 0.0625 x 0.012
