liacson-ops/3d-pato-criollo/salida/mjcf/mallas/servo_cadera_yaw_izq.stl

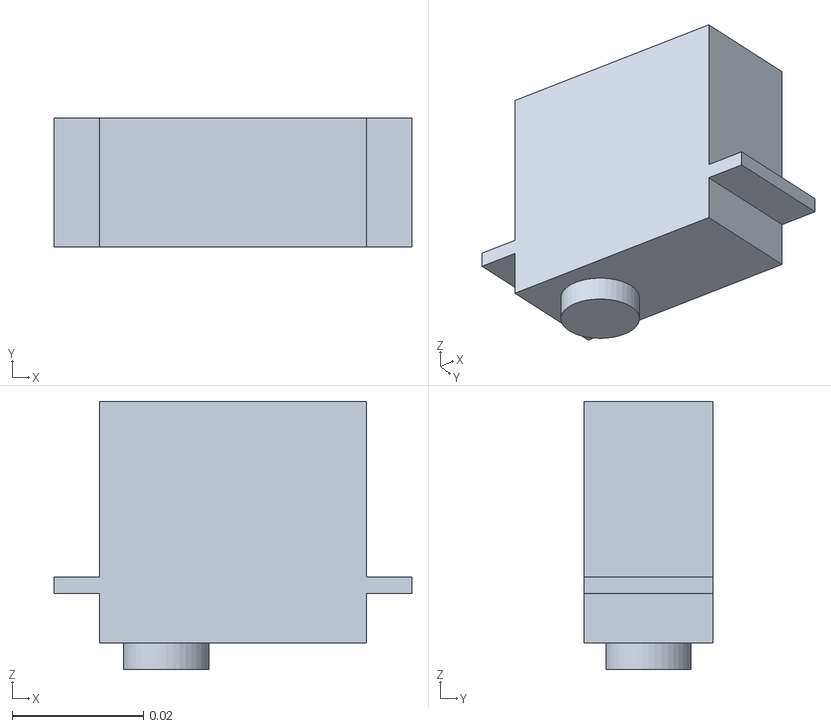
[picture p76: CAD file, 2026-10-25]
salida/mjcf/mallas/servo_cadera_yaw_izq.stl
0.0545 x 0.0197 x 0.0408
