liacson-ops/3d-pato-criollo/salida/mjcf/mallas/pico_inferior.stl

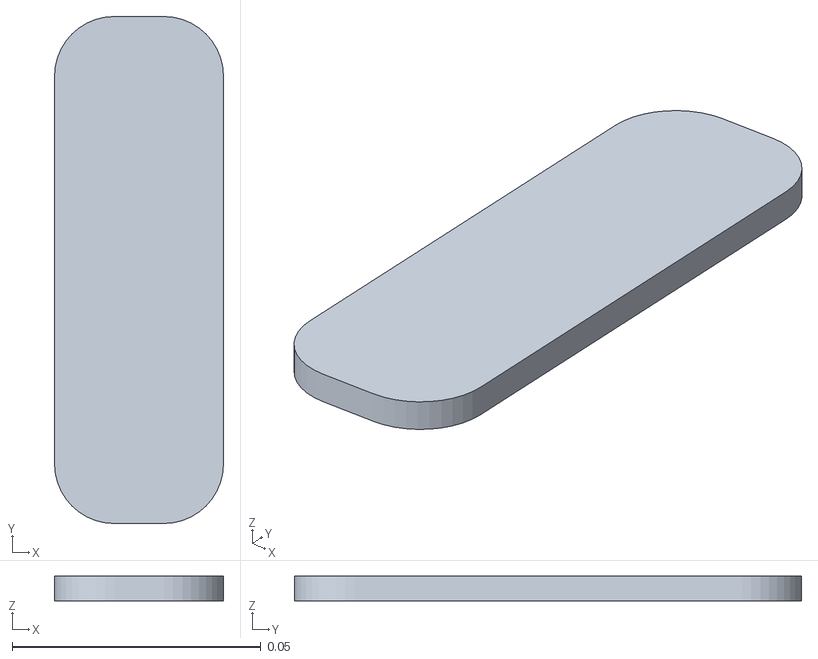
[picture p77: CAD file, 2026-10-25]
salida/mjcf/mallas/pico_inferior.stl
0.034 x 0.102 x 0.005
