liacson-ops/3d-pato-criollo/salida/mjcf/mallas/piso_tronco.stl

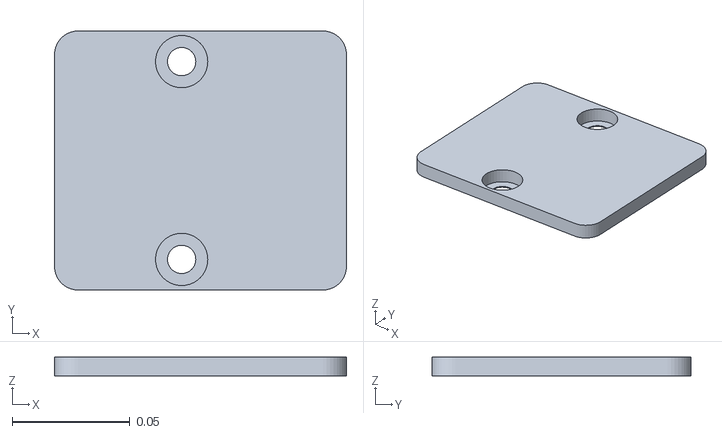
[picture p78: CAD file, 2026-10-25]
salida/mjcf/mallas/piso_tronco.stl
0.124 x 0.11 x 0.008
