liacson-ops/3d-pato-criollo/salida/mjcf/mallas/cupula.stl

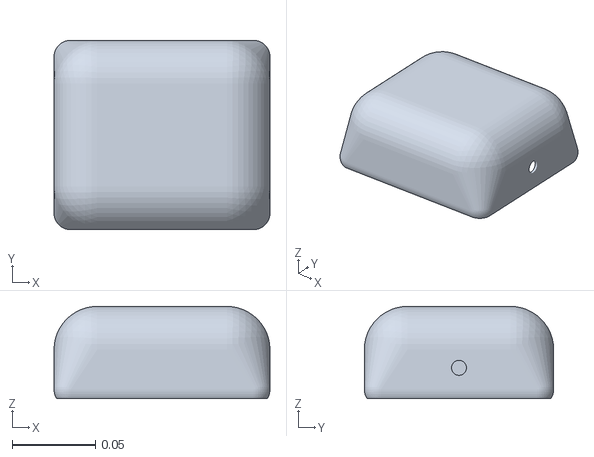
[picture p79: CAD file, 2026-10-25]
salida/mjcf/mallas/cupula.stl
0.13 x 0.114 x 0.0555
