liacson-ops/3d-pato-criollo/salida/mjcf/mallas/horn_cuello_yaw.stl

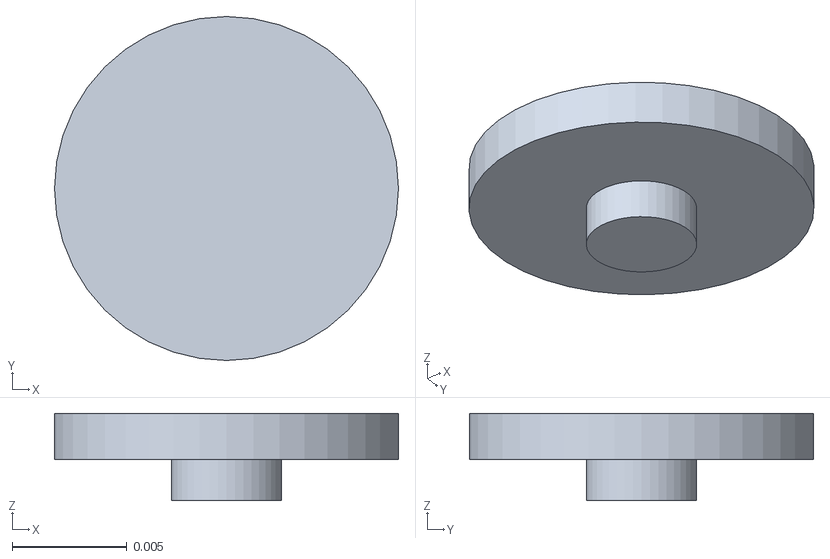
[picture p80: CAD file, 2026-10-25]
salida/mjcf/mallas/horn_cuello_yaw.stl
0.015 x 0.015 x 0.0038
