liacson-ops/3d-pato-criollo/salida/mjcf/mallas/tapa_bateria.stl

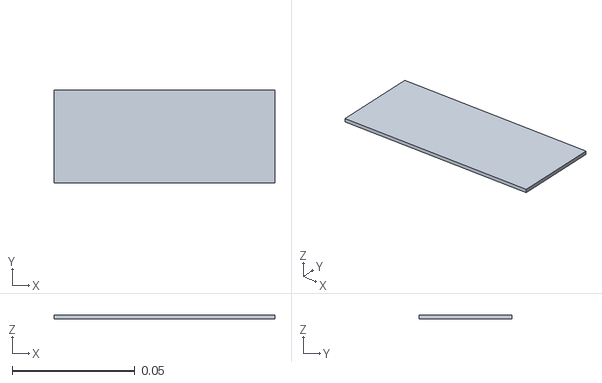
[picture p81: CAD file, 2026-10-25]
salida/mjcf/mallas/tapa_bateria.stl
0.09 x 0.038 x 0.0015
