liacson-ops/3d-pato-criollo/salida/mjcf/mallas/lipo_2s_1500.stl

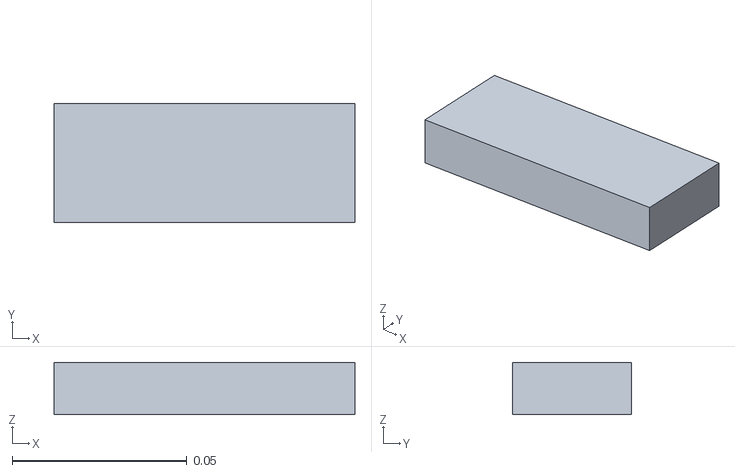
[picture p82: CAD file, 2026-10-25]
salida/mjcf/mallas/lipo_2s_1500.stl
0.086 x 0.034 x 0.015
