liacson-ops/3d-pato-criollo/salida/mjcf/mallas/orejas_tobillo_izq.stl

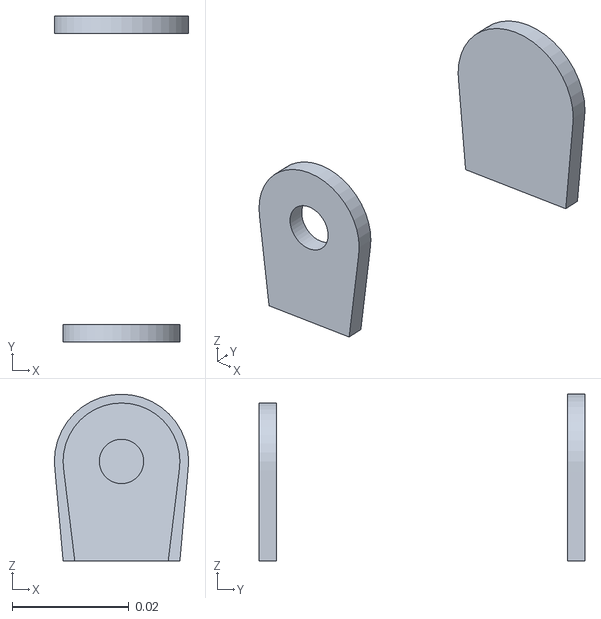
[picture p83: CAD file, 2026-10-25]
salida/mjcf/mallas/orejas_tobillo_izq.stl
0.023 x 0.0558 x 0.0285
