liacson-ops/3d-pato-criollo/salida/mjcf/mallas/ruleman_cadera_der.stl

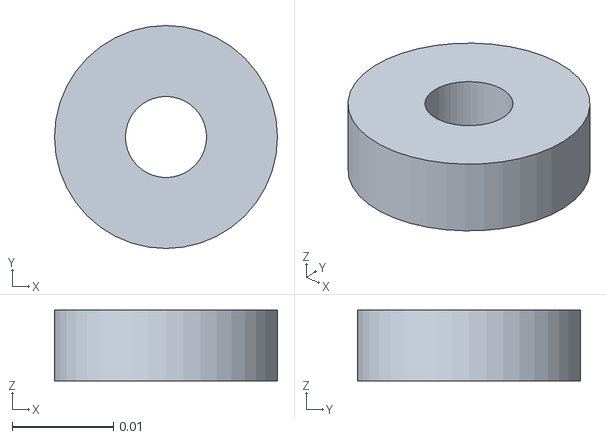
[picture p84: CAD file, 2026-10-25]
salida/mjcf/mallas/ruleman_cadera_der.stl
0.022 x 0.022 x 0.007
