liacson-ops/3d-pato-criollo/salida/mjcf/mallas/lente.stl

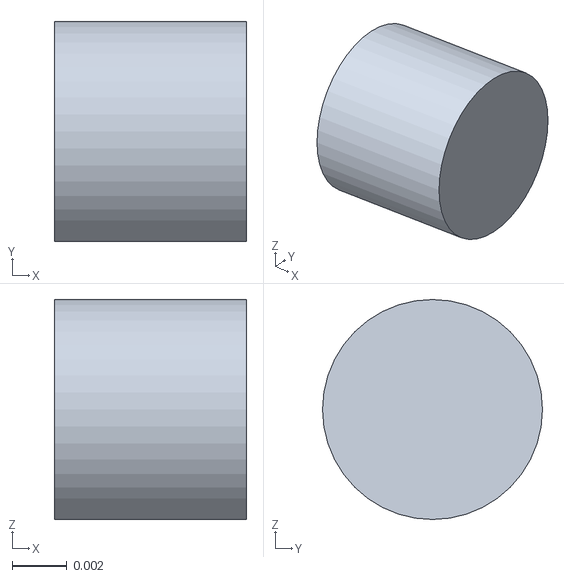
[picture p85: CAD file, 2026-10-25]
salida/mjcf/mallas/lente.stl
0.007 x 0.008 x 0.008
