liacson-ops/3d-pato-criollo/salida/mjcf/mallas/soporte_camara.stl

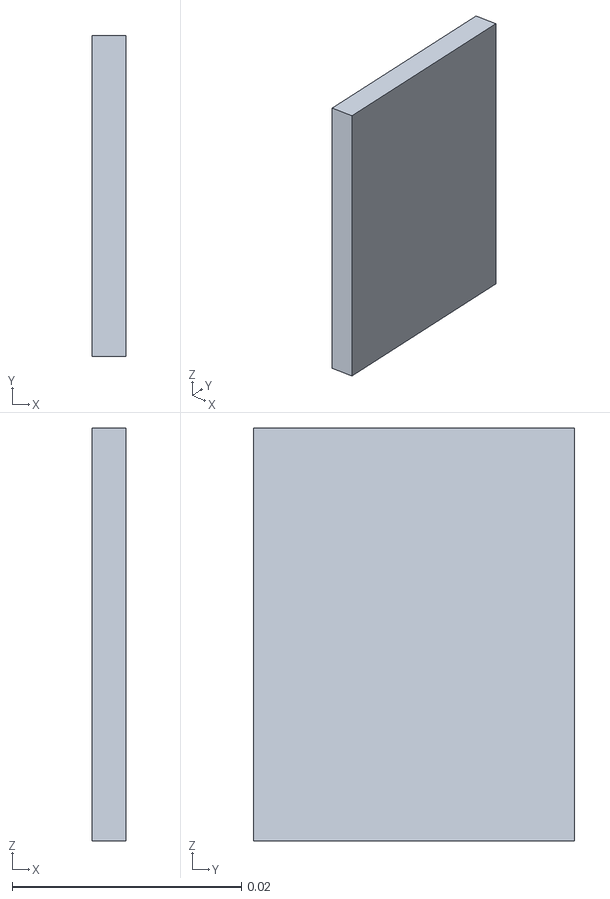
[picture p86: CAD file, 2026-10-25]
salida/mjcf/mallas/soporte_camara.stl
0.003 x 0.028 x 0.036
