liacson-ops/3d-pato-criollo/salida/mjcf/mallas/camara.stl

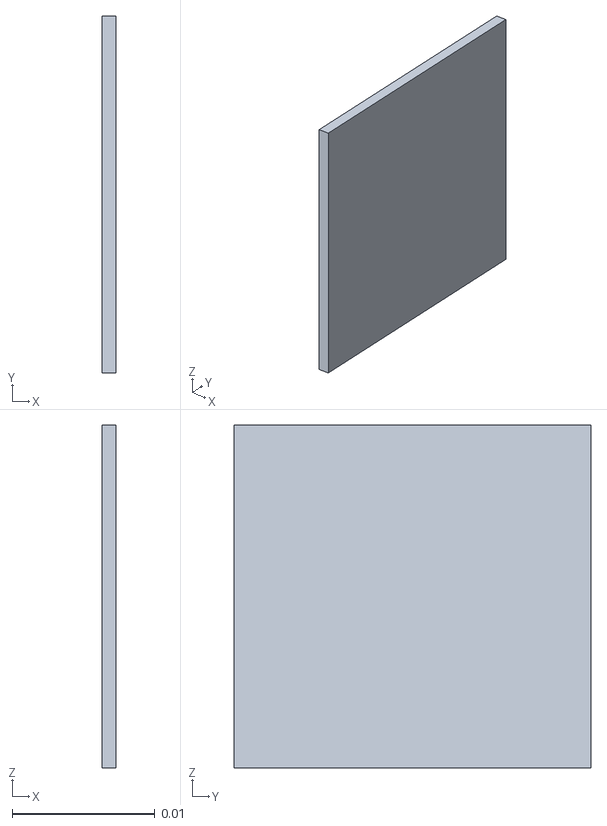
[picture p87: CAD file, 2026-10-25]
salida/mjcf/mallas/camara.stl
0.001 x 0.025 x 0.024
