liacson-ops/3d-pato-criollo/salida/mjcf/mallas/cabeza_inferior.stl

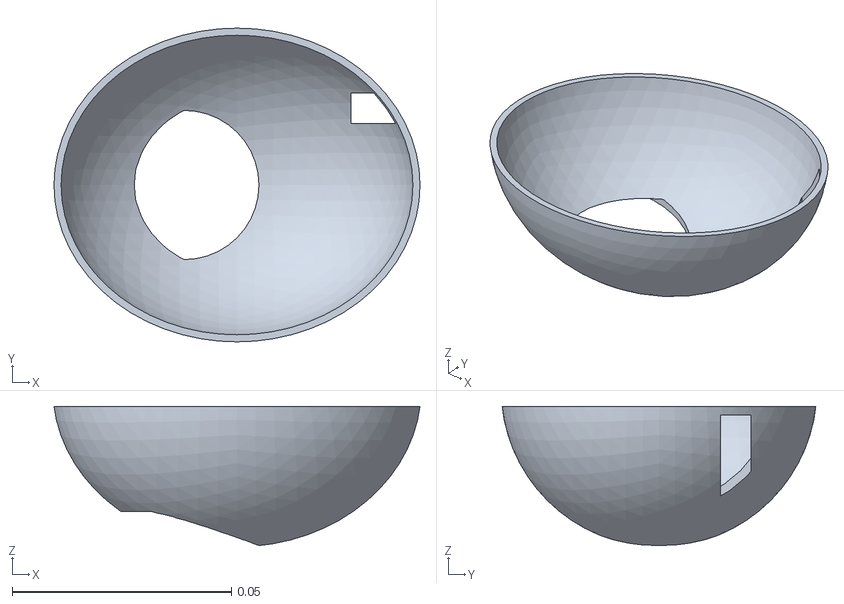
[picture p88: CAD file, 2026-10-25]
salida/mjcf/mallas/cabeza_inferior.stl
0.0834 x 0.0715 x 0.0317
