liacson-ops/3d-pato-criollo/salida/mjcf/mallas/ojos.stl

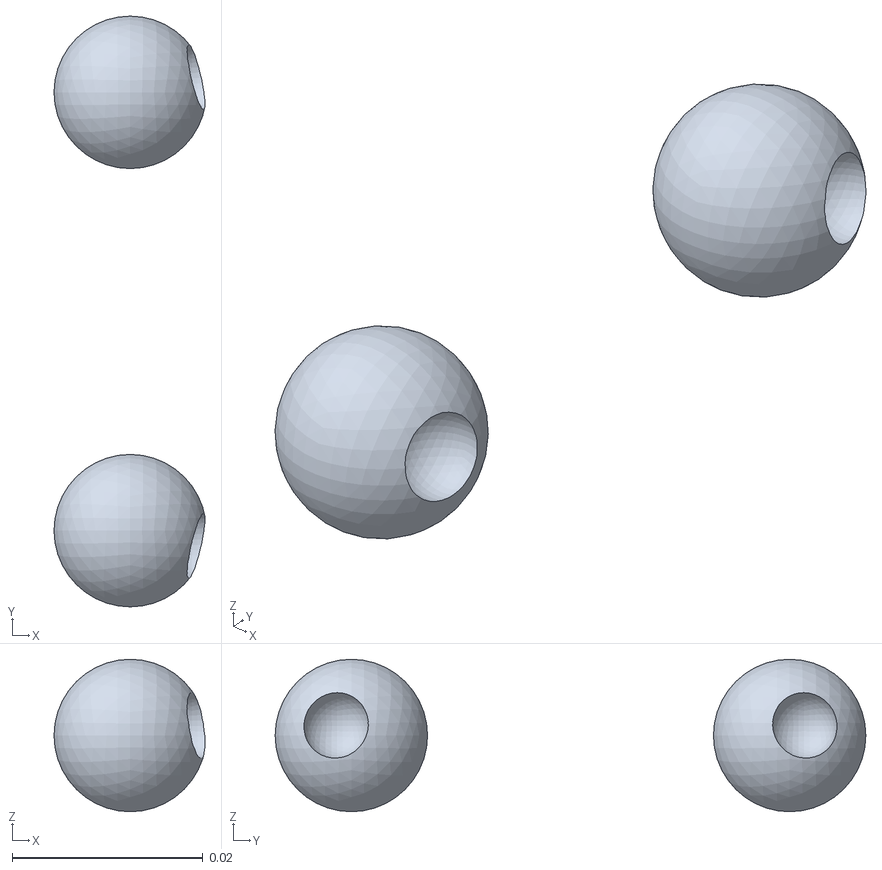
[picture p89: CAD file, 2026-10-25]
salida/mjcf/mallas/ojos.stl
0.0158 x 0.062 x 0.016
