liacson-ops/3d-pato-criollo/salida/mjcf/mallas/pupilas.stl

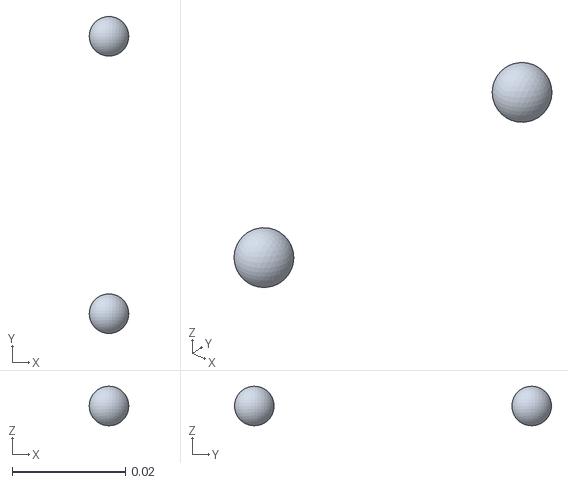
[picture p90: CAD file, 2026-10-25]
salida/mjcf/mallas/pupilas.stl
0.007 x 0.056 x 0.007
