liacson-ops/3d-pato-criollo/salida/mjcf/mallas/pico_inf.stl

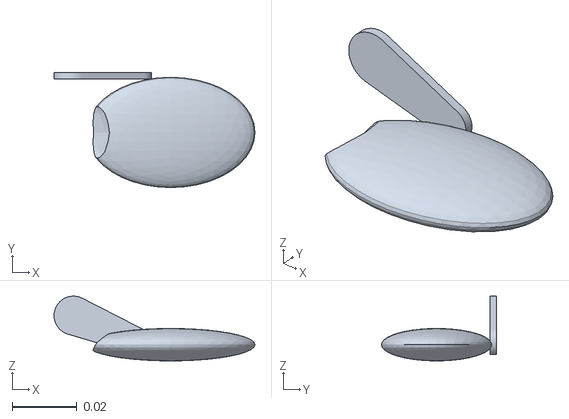
[picture p91: CAD file, 2026-10-25]
salida/mjcf/mallas/pico_inf.stl
0.062 x 0.0355 x 0.02
