liacson-ops/3d-pato-criollo/salida/mjcf/mallas/soporte_cabeza.stl

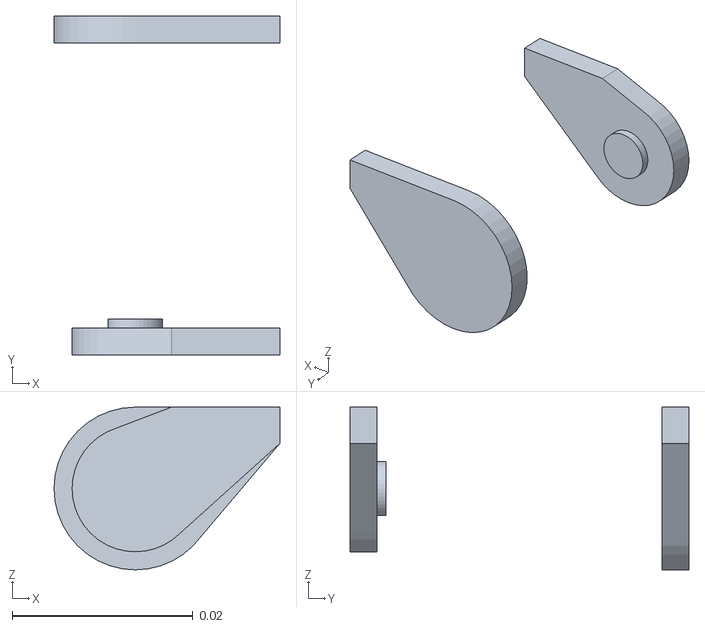
[picture p92: CAD file, 2026-10-25]
salida/mjcf/mallas/soporte_cabeza.stl
0.025 x 0.0375 x 0.018
