liacson-ops/3d-pato-criollo/salida/mjcf/mallas/cabeza_superior.stl

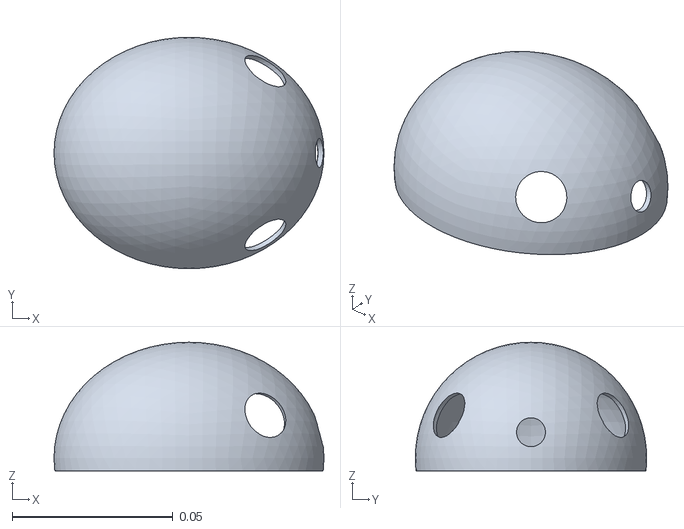
[picture p93: CAD file, 2026-10-25]
salida/mjcf/mallas/cabeza_superior.stl
0.084 x 0.072 x 0.04
