liacson-ops/3d-pato-criollo/(list of files, cad)

Other CAD files:
salida/mjcf/mallas/horn_cadera_pitch_izq.stl
salida/mjcf/mallas/servo_cadera_pitch_izq.stl
salida/mjcf/mallas/suela_der.stl
salida/piezas_impresas/soporte_u_der.stl
salida/mjcf/mallas/servo_tobillo_der.stl
salida/mjcf/mallas/horn_tobillo_izq.stl
salida/mjcf/mallas/soporte_u_der.stl
salida/mjcf/mallas/paleta_pie_izq.stl
salida/piezas_impresas/soporte_canilla_izq.stl
salida/mjcf/mallas/servo_cadera_roll_der.stl
salida/piezas_impresas/ojo_disco_der.stl
salida/mjcf/mallas/placa_yaw_izq.stl
salida/mjcf/mallas/horn_rodilla_der.stl
salida/piezas_impresas/soporte_muslo_izq.stl
salida/mjcf/mallas/soporte_canilla_der.stl
salida/piezas_impresas/placa_yaw_der.stl
salida/mjcf/mallas/horn_tobillo_der.stl
salida/piezas_impresas/soporte_pie_der.stl
salida/piezas_impresas/suela_izq.stl
salida/mjcf/mallas/servo_tobillo_izq.stl
salida/piezas_impresas/ojo_aro_der.stl
salida/mjcf/mallas/servo_cadera_pitch_der.stl
salida/piezas_impresas/paleta_pie_der.stl
salida/mjcf/mallas/horn_cadera_pitch_der.stl
salida/piezas_impresas/orejas_tobillo_der.stl
salida/mjcf/mallas/soporte_pie_izq.stl
salida/mjcf/mallas/servo_rodilla_der.stl
salida/mjcf/mallas/horn_cadera_roll_izq.stl
salida/mjcf/mallas/soporte_muslo_der.stl
salida/mjcf/mallas/horn_cadera_roll_der.stl
salida/mjcf/mallas/horn_cadera_yaw_izq.stl
salida/mjcf/mallas/xl4016_izq.stl
salida/mjcf/mallas/ojo_aro_izq.stl
salida/mjcf/mallas/ojo_disco_izq.stl
salida/mjcf/mallas/horn_cadera_yaw_der.stl
salida/mjcf/mallas/servo_cadera_yaw_der.stl
salida/mjcf/mallas/servo_cuello_yaw.stl
salida/mjcf/mallas/orejas_tobillo_der.stl
salida/mjcf/mallas/ruleman_cadera_izq.stl
salida/mjcf/mallas/servo_boca.stl
salida/mjcf/mallas/horn_boca.stl
salida/mjcf/mallas/horn_cuello_pitch.stl
