liacson-ops/3d-pato-criollo/(commit log)

2026-10-25 Pato Criollo v0: modelo 3D paramétrico, simulación, visor y plan
    - cad/: robot completo con medidas reales de MG996R, MG90S, Pi Zero 2 W,
    LiPo 2S, PCA9685, XL4016, MCP3008 y GY-521; 67 piezas, 13 articulaciones,
    sin interferencias entre piezas.
    - sim/: torques estáticos en MuJoCo (parado, cuclillas y en una pata).
    - visor/: visor three.js autocontenido (salida/pato.html) con modos armado,
    rayos X, explotado y paso a paso; capturas automáticas en docs/img.
    - PLAN.md y COMPRAS-FASE0.md: plan, presupuesto y compras del banco de pruebas.
    Claude-Session: https://claude.ai/code/session_01CqjVP1fZynGSq8jL9ndNrt
    [cabeza_inferior.stl, cabeza_superior.stl, camara.stl, cuerpo_inferior.stl, cuerpo_superior.stl, estante_a.stl, estante_b.stl, horn_boca.stl]
2026-10-25 Cabeza y tronco al estilo del pato original
    Cúpula tipo pan con ojo redondo amarillo a cada lado, pico ancho y chato que
    abre como una tapa desde atrás (mandíbula = piso de la cabeza), cámara en la
    frente, tronco cajita blanco sin cola. Electrónica reubicada en los estantes
    rectangulares. Sin interferencias entre piezas; torques y capturas regenerados.
    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
    [base_cabeza.stl, camara.stl, cuerpo_inferior.stl, cuerpo_superior.stl, cupula.stl, estante_a.stl, estante_b.stl, horn_boca.stl]
2026-10-25 PLAN: masa actualizada tras la cabeza nueva
    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
2026-10-25 Patas compactas, 31,5 cm, y simulador físico en el navegador
    - Servos de cadera pitch, rodilla y tobillo acostados en una cuna impresa única;
    muslo y canilla de 32 mm; tronco apretado. El robot pasa de 38 a 31,5 cm.
    - Exportación de pato_sim.xml (cajas de choque) y sim/marcha.py (marcha a mano,
    barrido de parámetros).
    - salida/simulador.html: MuJoCo WebAssembly + three.js en un solo archivo, con
    modos parado/caminar/manual/soltar, empujones, torque por servo y prueba
    automática (visor/probar_sim.mjs).
    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
    [base_cabeza.stl, cuerpo_inferior.stl, cuerpo_superior.stl, cupula.stl, estante_a.stl, estante_b.stl, horn_boca.stl, horn_cadera_pitch_der.stl]
2026-10-25 Cadera yaw con MG996R
    Los MG90S saturaban al caminar. Los MG996R van parados dentro del tronco,
    sujetos por las orejas al estante A; tronco de 110 mm de ancho y cabeza de 114.
    Torques, marcha, visor, simulador y capturas regenerados. Nota sobre
    entrenamiento en Apple Silicon en PLAN.md.
    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
    [base_cabeza.stl, cuerpo_inferior.stl, cuerpo_superior.stl, cupula.stl, estante_a.stl, estante_b.stl, horn_cadera_yaw_der.stl, horn_cadera_yaw_izq.stl]
2026-10-25 Patas sin cruces, marcha corregida y entorno de entrenamiento para Mac
    - cad/choques.py: verificación de intersección entre piezas en 72 poses
    (reposo, marcha, topes, cabeza girada con la boca abierta): sin cruces.
    - Patas: cunas alternadas (cadera atrás, rodilla adelante, tobillo atrás),
    topes por articulación medidos con el escaneo de choques.
    - Modelo de simulación: cajas por pieza en las patas (la caja única de la
    canilla bajaba más que la suela), mallas reales en pato.xml y pato_rl.xml
    (antes quedaban como esferas por falta de type="mesh").
    - Marcha a mano: signo del balanceo medido con los apoyos; camina 33 cm en
    8 s y aguanta empujones de 4 N. Nuevos valores por defe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
    [base_cabeza.stl, cuerpo_inferior.stl, cuerpo_superior.stl, cupula.stl, estante_a.stl, estante_b.stl, horn_boca.stl, horn_cadera_pitch_der.stl]
2026-10-25 Marcha a mano más rápida: 2 pasos/s, 6 cm/s
    Nuevos valores por defecto en sim/marcha.py y en el simulador web:
    frecuencia 2,0, balanceo 0,05, zancada 0,24. Camina 51 cm en 8 s con
    picos de torque del 79 % y aguanta empujones de 4 N caminando.
    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
2026-10-25 jugar.py: en macOS la ventana necesita mjpython
    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
2026-10-25 entrenar.py: guarda el modelo cada 100 k pasos para mirarlo mientras entrena
    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
2026-10-25 jugar.py: detectar mjpython por el error de MuJoCo, no por el nombre del intérprete
    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
2026-10-25 pato_rl.xml: mallas visuales con color para verlo en el visor de MuJoCo
    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
    [pato_rl.xml]
2026-10-25 Recompensa contra el salto en el lugar; jugar.py --semilla
    La primera corrida aprendió a saltar sin avanzar. Ahora avanzar paga de forma
    lineal, el seguimiento de velocidad es más ancho, el bono por estar vivo baja,
    el tiempo en el aire solo cuenta con un pie apoyado y se penalizan volar y
    rebotar. Documentado en rl/README.md.
    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
2026-10-25 rl: política de levantarse, gestos de la cabeza y supervisor
    - entorno.py: modo levantarse (arranca de espaldas, de frente o de costado;
    bono al quedar medio segundo de pie) y cabeza al azar al entrenar la marcha.
    - cabeza.py: gestos programados (mirar arriba y abrir la boca, mirar alrededor,
    mirar abajo, cuac) dentro de la envolvente boca/pitch.
    - jugar.py: supervisor caminar/levantarse, --demo, --caido, --gesto, ONNX de
    las dos políticas. entrenar.py: --modo, config.json, ultimo_<modo>.
    - exportar_onnx.py: pato_caminar.onnx / pato_levantarse.onnx.
    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
2026-10-25 rl/README: levantarse no es posible con la mecánica actual (búsqueda exhaustiva) y alternativas
    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
2026-10-25 jugar.py: dice qué corrida carga y no usa una corrida de otro modo como marcha
    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
2026-10-25 Navegación A→B, seguimiento con la cámara y ajustes para una corrida larga
    - pato_rl.xml: cámara de la Pi en la cabeza y una pelota (mocap) para seguir.
    - rl/navegar.py: Navegador (puntos x,y -> comando) y Seguidor (objeto en la
    imagen -> cabeza que lo centra, cuerpo que gira y se acerca).
    - rl/jugar.py: --ir-a y --seguir, con resumen de puntos alcanzados y tiempo
    con la pelota centrada.
    - entorno.py: premio al giro pedido más fuerte (giraba sobre su eje).
    - entrenar.py: tasa de aprendizaje que baja linealmente; --lr; --pasos 60e6
    para toda la noche.
    Claude-Session: https://claude.ai/code/session_01CqjVP1fZynGSq8jL9ndNrt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
    [pato_rl.xml]
2026-10-26 Marcha de pato natural: reloj de paso, piso de casa, comandos tranquilos y "en brazos"
    - entorno.py: reloj de paso a 1,6 Hz en la observación (41 valores) y premio
    por seguirlo (pie en el aire, hasta 8 mm); penalizaciones de suavidad más
    fuertes; velocidad pedida baja la mayor parte del tiempo y premio estrecho;
    campo de alturas con umbrales/alfombras o rampas en el 60 % de los episodios;
    detección de alzado (medio segundo sin pies apoyados).
    - pato_rl.xml: terreno (hfield) de 4×4 m, plano en el centro.
    - jugar.py: modo "en brazos" en el supervisor, --alzar (una mano lo levanta
    y lo apoya), --terreno, comando por defecto 10 cm/s.
    - navegar.py: velocidades de navegación y segui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
    [pato_rl.xml]
2026-10-26 Simulador web: ejemplos de comportamiento (A→B, seguir la pelota, gestos, alzado)
    Sobre la marcha a mano: recorrido por tres puntos marcados, seguimiento de
    una pelota con la cabeza y el cuerpo (con la imagen simulada de la cámara),
    gestos de cuac mirando arriba y mirar alrededor, y una mano que lo alza:
    recoge las patas, mira arriba y sigue cuando lo apoyan.
    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
2026-10-26 Simulador web: los ejemplos doblan caminando, con el giro acotado
    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
2026-10-26 Simulador web: el seguimiento arranca y frena en suave por la amplitud de la marcha
    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
2026-10-26 Simulador web: el seguidor de la pelota corre a 50 Hz efectivos (oscilaba de tope a tope)
    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
2026-10-26 Simulador web: seguidor sobre el ángulo medido de la cabeza y búsqueda girando el cuerpo
    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
2026-10-26 Recompensa: el reloj de paso solo paga en la medida en que avanza (marcaba el paso en el lugar)
    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
2026-10-26 Recompensa: imitar la marcha a mano como referencia (fase correcta desde el arranque)
    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
2026-10-26 Referencia de marcha acotada a la amplitud de la marcha a mano
    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
2026-10-26 Entrenar con velocidades parejas hasta 25 cm/s; el paso lento es el comando de uso
    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
2026-10-26 rl/README: lecciones de la marcha natural (imitación y distribución de velocidades)
    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
